idoodler/robo-garage/README.md

# Robo-Garage

Kitchen cabinet garage for a **Dreame L10s Pro Ultra Heat** robot vacuum.
ESP32 + ESPHome + Home Assistant: motorised door, light barrier, reed contacts, fan, LED ring, temperature/humidity, water leak probe + valve, buzzer.

**Live simulator:** https://claude.ai/artifact/KapGY8dMDmhuJijCuEXQXC

## Versions

| Part | Version | Status |
|---|---|---|
| Controller PCB | v1.3.1 | DRC 0 errors / 0 warnings (KiCad 7). JLCPCB assembles all parts (SMD + clamps), only the DevKitC is plugged in (USB-C reachable from outside). Power headroom: 12 V in 6 A, actuator 4.9 A limit, valve 3 A, every power path checked against IPC-2221. v1.3.1: clamp pins in 2 rows like the real part, pick & place rotations computed from JLC's own footprints |
| Case | v1.3.1 | fits PCB v1.3.1 (0 mm³ overlap with the part stand-in), DevKit USB-C through the left wall |
| ESPHome config | – | checked with ESPHome 2026.10.2. Set in HA without reflashing: beam type, actuator type (with / without built-in limit switches), open / close time, motor current threshold, stall current; "Door motor fault" when a move draws no current. Light barrier: retroreflective NPN sensor (E3Z-R61 type, Light-ON) + reflector on the BEAM clamp, blue wire on TX− so the self-test can switch it off (no PCB change). Line LED: SK6812 RGBW 144/m, 72 LEDs, capped at 25 % per channel (≤ 1.44 A of the 1.5 A LED output) |
| Simulator | v5.6 | door open slider for all 4 door types, printed door parts (doors v2.2) in 3D + side view, door downloads, retroreflective light barrier with its reflector, Line LED with 72 SK6812 RGBW LEDs |
| Doors | v2.2 | Printed parts for all 4 door types (lift door, flap out, up & over, parallel lift), no supports. Up & over + parallel lift: print-in-place modules with hourglass joints and hollow pins, skeleton plates and arms checked by 3D FE as printed (`check_strength.py`): 12 % less filament than v2.1 (both module pairs together), the most loaded spot down from 1.35 to 0.87 of its allowable at a 100 N stall (calculated), checked over the whole travel (joint gap 0.45 mm, up & over peg in its track 0.4 mm, other gaps ≥ 1 mm). Parallel lift parks 23 mm out (40 mm max) |

## Folders

| Folder | What is inside |
|---|---|
| `esphome/` | ESPHome config for the board (needs `secrets.yaml` with `wifi_ssid`, `wifi_password`) |
| `homeassistant/` | Home Assistant blueprint `robo-garage.yaml`: door follows the robot vacuum, clean button, button ring + status LED, rear fan drying, iOS Live Activities, messages (see below) |
| `pcb/gen/` | PCB generator (Python + KiCad `pcbnew`). `parts.py` = single source of truth, `fplib.py` makes the own footprints (`pcb/lib/robo.pretty`) |
| `pcb/robo-garage/` | Work folder. Only `robo-garage.ses` (Freerouting result) is in git |
| `pcb/out/` | Order files: gerbers zip, BOM + CPL for JLCPCB, KiCad project, renders, `pin1-check.png`. **Order guide: `pcb/out/README.md`** |
| `case/` | 3D-printed case: OpenSCAD source, STL files, pictures, print guide |
| `doors/` | Printed door parts for all 4 door types: OpenSCAD source, STL files, check scripts, print + assembly guide (`doors/README.md`) |
| `simulator/` | Simulator web page: `robo-garage.html` (source) → `build_page.py` → `index.html` |

## Build

GitHub Actions runs all of this on every push (`.github/workflows/build.yml`).
Locally: run from the repo root. Tested with KiCad 7.0.11 (Python `pcbnew`), Python 3 + shapely 2.2, OpenSCAD 2021.01.

| Step | Command |
|---|---|
| PCB: bare board | `python3 pcb/gen/build.py` |
| PCB: tracks + GND pour + DRC | `python3 pcb/gen/finish.py` (stops with an error on any DRC issue) |
| PCB: gerbers, BOM, CPL, renders | `python3 pcb/gen/fab.py pcb/robo-garage/robo-garage_routed.kicad_pcb pcb/out` |
| PCB: copy to `pcb/out` + zip | `pcb/gen/package.sh` |
| PCB: re-route (optional) | `pcb/gen/pipeline.sh` (Freerouting is not deterministic: run it again if `finish.py` reports unconnected items) |
| Case: PCB data, STL, zip | `case/build.sh` |
| Doors: STL, zip | `doors/build.sh` (other joint gap: `doors/build.sh -D cj=0.35`) |
| Doors: motion, gap and overhang checks | `python3 doors/check_parallel.py`, `python3 doors/check_upover.py`, `python3 doors/check_simple.py` |
| Doors: strength (joint loads + 3D FE as printed, about 6 min on 32 cores, up to 48 GB; `--jobs=1` for less) | `python3 doors/check_strength.py` (misuse case: `--yank`) |
| Simulator page | `python3 simulator/build_files.py` (downloads, pictures, case + door GLB) then `python3 simulator/build_page.py` |
| Flash ESP32 | `esphome run esphome/robo-garage-pcb.yaml` |

| Tool | Needed for |
|---|---|
| Python packages `shapely` 2.2, `segno` 1.6 (QR code on the silkscreen) | `build.py`, `finish.py` |
| `kicad-cli`, `rsvg-convert`, Python package `Pillow` | `fab.py` |
| `zip` | `package.sh`, `case/build.sh`, `doors/build.sh` |
| `openscad`, font DejaVu Sans | `case/build.sh`, `doors/build.sh`, `simulator/build_files.py` |
| Python packages `trimesh`, `rtree`, `shapely`, `numpy`; `xvfb-run` for `render.py`; `scipy`, `pyamg` for `check_strength.py`; `matplotlib` for `paper_template.py` (run by `doors/build.sh`) | `doors/check_*.py`, `doors/render.py`, `doors/paper_template.py` |
| Python packages `Pillow`, `trimesh`, `numpy`, `shapely`, `fast-simplification` | `simulator/build_files.py` |
| Java, `xvfb-run`, `pcb/tools/freerouting-1.9.0.jar` ([Freerouting releases](https://github.com/freerouting/freerouting/releases)) | `pipeline.sh` only |

Moved a part in `parts.py`? Then the old tracks no longer fit: run `pcb/gen/pipeline.sh` and commit the new `pcb/robo-garage/robo-garage.ses`.

## Home Assistant

Blueprint `homeassistant/robo-garage.yaml` (HA 2026.7 or newer). Import it: *Settings → Automations & scenes → Blueprints → Import blueprint*, URL
`https://github.com/idoodler/robo-garage/blob/main/homeassistant/robo-garage.yaml`, then *Create automation* and pick the robot vacuum and the Robo-Garage entities.

| What happens | How |
|---|---|
| Robot leaves the dock or starts returning | door opens; not open within the time limit or a door motor fault → robot paused + message. Dreame mop wash / drying after the job (reports "cleaning" while docked) keeps the door shut |
| Robot back in the dock, job over, for 1 min (set it) | door closes; beam blocked → the controller reopens, the blueprint waits for a clear beam and tries again (3×), then a message. Dreame: waits while the job still runs in the dock (mop washing, recharge) |
| Clean button | robot docked → door opens, then the robot starts (not on a door motor fault). Robot out → sent home (or paused / nothing) |
| Button ring | on while the robot is parked (brightness set it, 0 = off), pulses during a job in the dock, blinks on a problem |
| Status LED (optional) | red strobe = problem, orange chase = door moving, blue bar = job progress ("Progress" effect + "Status LED progress" number), spinner = returning, pulse = washing / charging in the dock, green = done (2 min), dim pulse = mop wash after the job |
| Water leak, beam fault, motor fault, stall, supply low, robot error | message to the notify entities you pick, else a notification in HA |
| Rear fan | after parking (door closed): fan at 60 % for 60 min (set both, 0 % = off), then back to "Vent auto". Stops early when the robot leaves |
| iOS Live Activities (optional, pick the phones; English or German) | cleaning job: a bar per room, current room + %, phase (mop wash, to the station, ...), door opening / closing, then done / stopped / error; outside a job the door status. Problems: one red list of every robot, station and garage problem, "✅ Problem solved" when all are clear. Made for the Dreame integration (task status, state, current room, progress, error, station sensors + a text and a toggle helper) |
| HA or controller restart | door put back where it belongs |
| Optional | close the door while the robot is out (opens again on "returning"); keep the door open while the drawer is out |

The safety work stays in the firmware: beam stop, stall stop, leak valve.

## Release

| Step | What to do |
|---|---|
| 1 | Set the versions: `VERSION` in `pcb/gen/parts.py` (also printed on the board), `version` in `case/robo-garage-case.scad` |
| 2 | Push to `main` → GitHub Actions builds everything and checks the DRC |
| 3 | Push a tag: `git tag v1.3.1 && git push origin v1.3.1` → GitHub Actions publishes the release with both zips |
| or | On github.com: *Releases* → *Draft a new release* → new tag `v1.3.1` → *Publish*. The zips get attached about 2 min later |

Every build also keeps both zips for 30 days: *Actions* → run → *Artifacts*.
