idoodler/robo-garage/doors/parallel_template.pdf

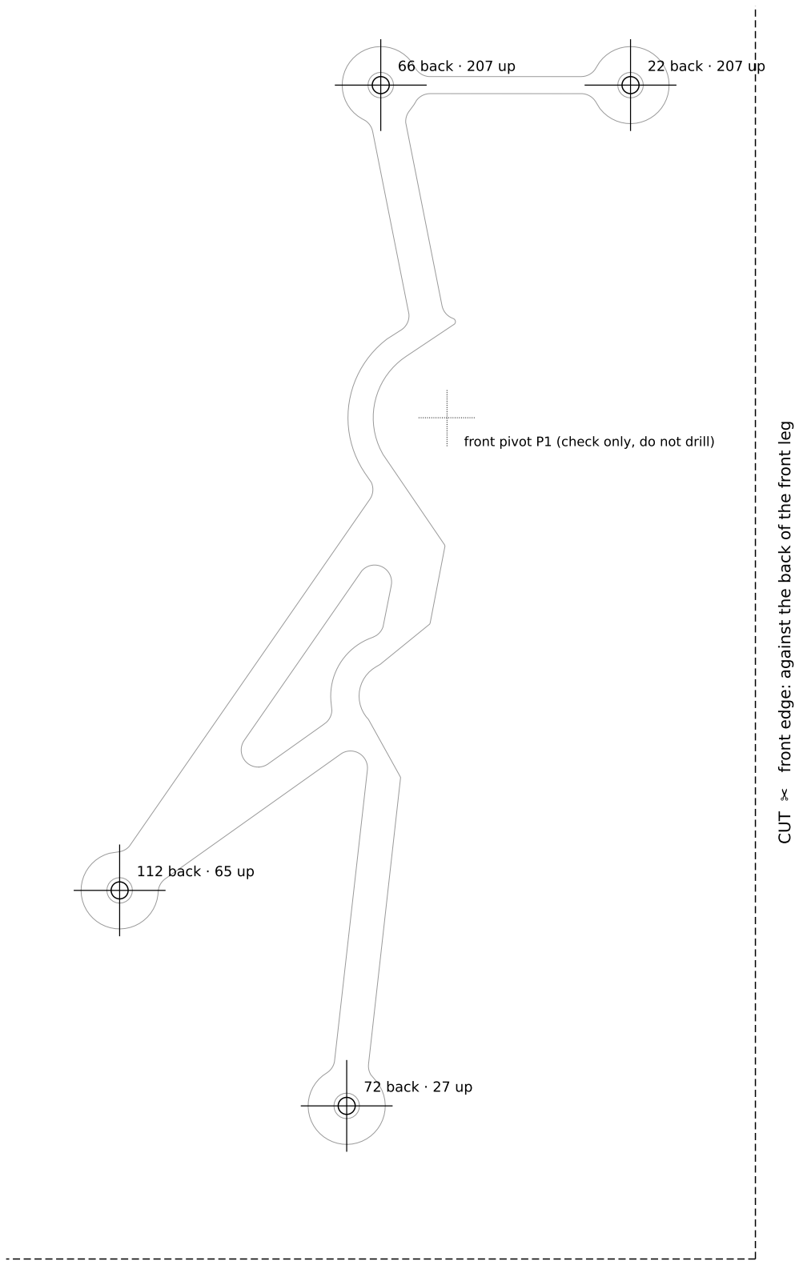
[picture p7: figure]
CUT; 66 back · 207 up; 22 back · 207 up; 72 back · 27 up; 112 back · 65 up

# ✂ front edge: against the back of the front leg

CUT ✂ bottom edge: on the tray front pivot P1 (check only, do not drill)

100 mm

100 mm

# Robo-Garage parallel lift v2.2: drill template, RIGHT cheek

Seen from the robot bay. Print on A4 at 100 % ("actual size", not "fit to page"): both bars must measure 100 mm.

Cut along both cut lines, tape it on, pre-drill the 4 crosses with 3 mm for 4 × 20 countersunk screws. Page 2 is the left cheek.

Hole positions from parallel-lift.scad (SCREWS); "back" = mm behind the front edge, "up" = mm above the tray.

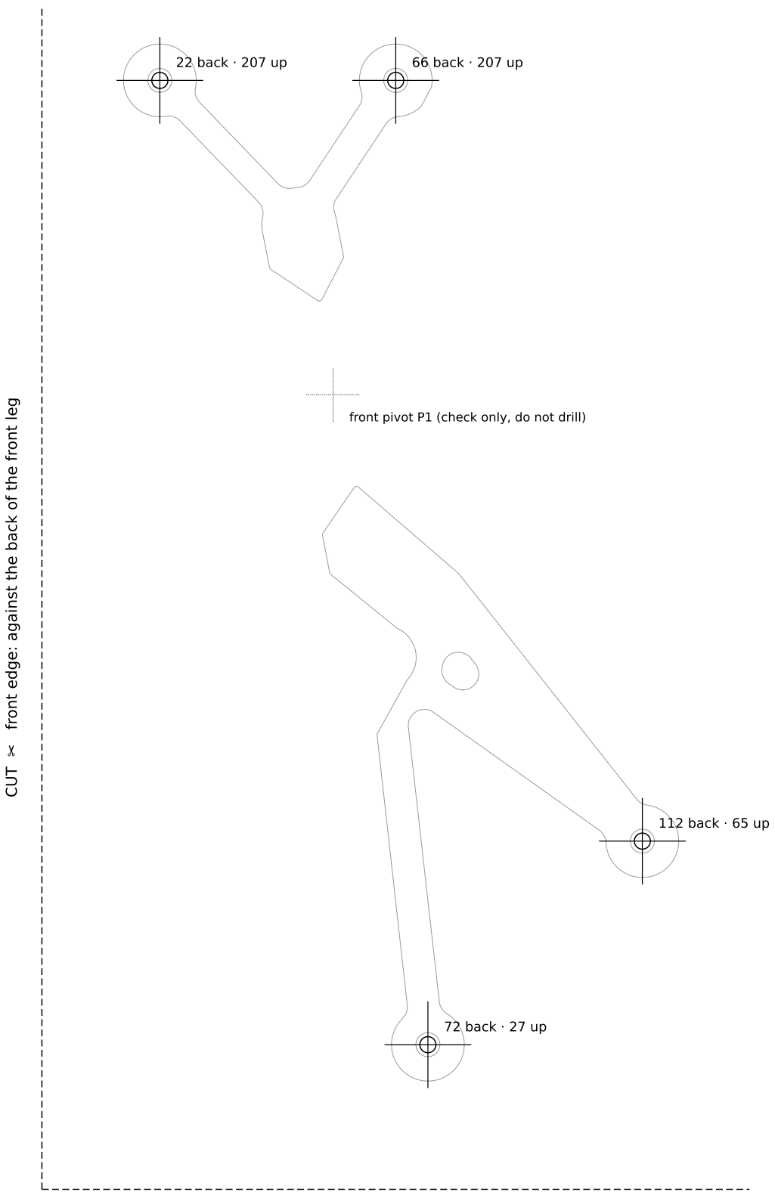
[picture p8: figure]
CUT; 22 back · 207 up; 66 back · 207 up; 72 back · 27 up; 112 back · 65 up

# ✂ front edge: against the back of the front leg

CUT ✂ bottom edge: on the tray front pivot P1 (check only, do not drill)

100 mm

100 mm

# Robo-Garage parallel lift v2.2: drill template, LEFT cheek

Seen from the robot bay. Print on A4 at 100 % ("actual size", not "fit to page"): both bars must measure 100 mm.

Cut along both cut lines, tape it on, pre-drill the 4 crosses with 3 mm for 4 × 20 countersunk screws. Page 1 is the right cheek.

Hole positions from parallel-lift.scad (SCREWS); "back" = mm behind the front edge, "up" = mm above the tray.
