idoodler/robo-garage/case/view_base.png

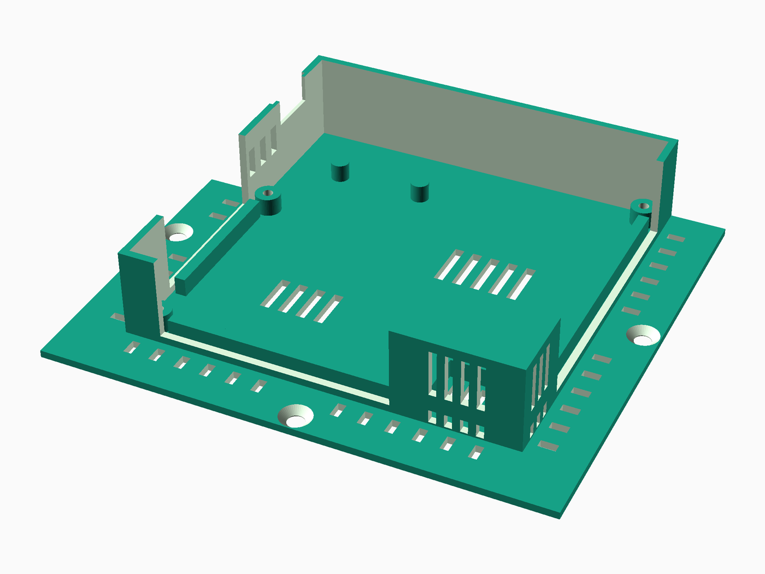
case/view_base.png
