idoodler/robo-garage/case/view_lid_top.png

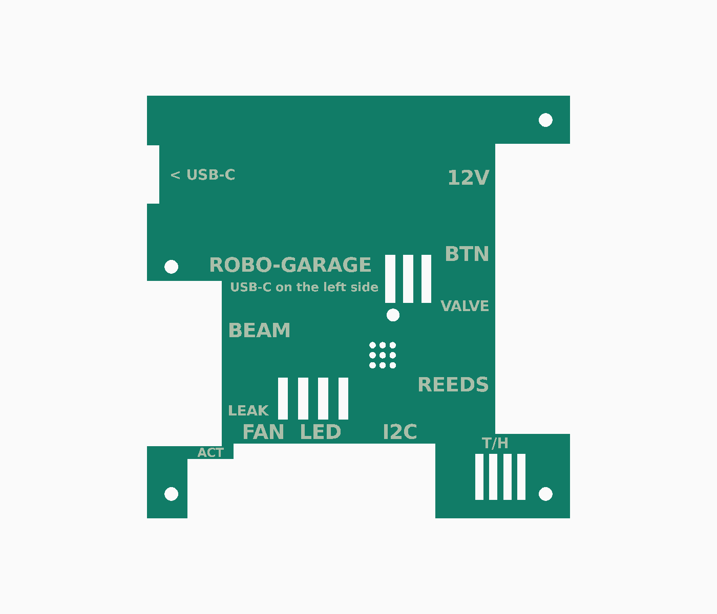
case/view_lid_top.png
