idoodler/robo-garage/pcb/out/pin1-check.png

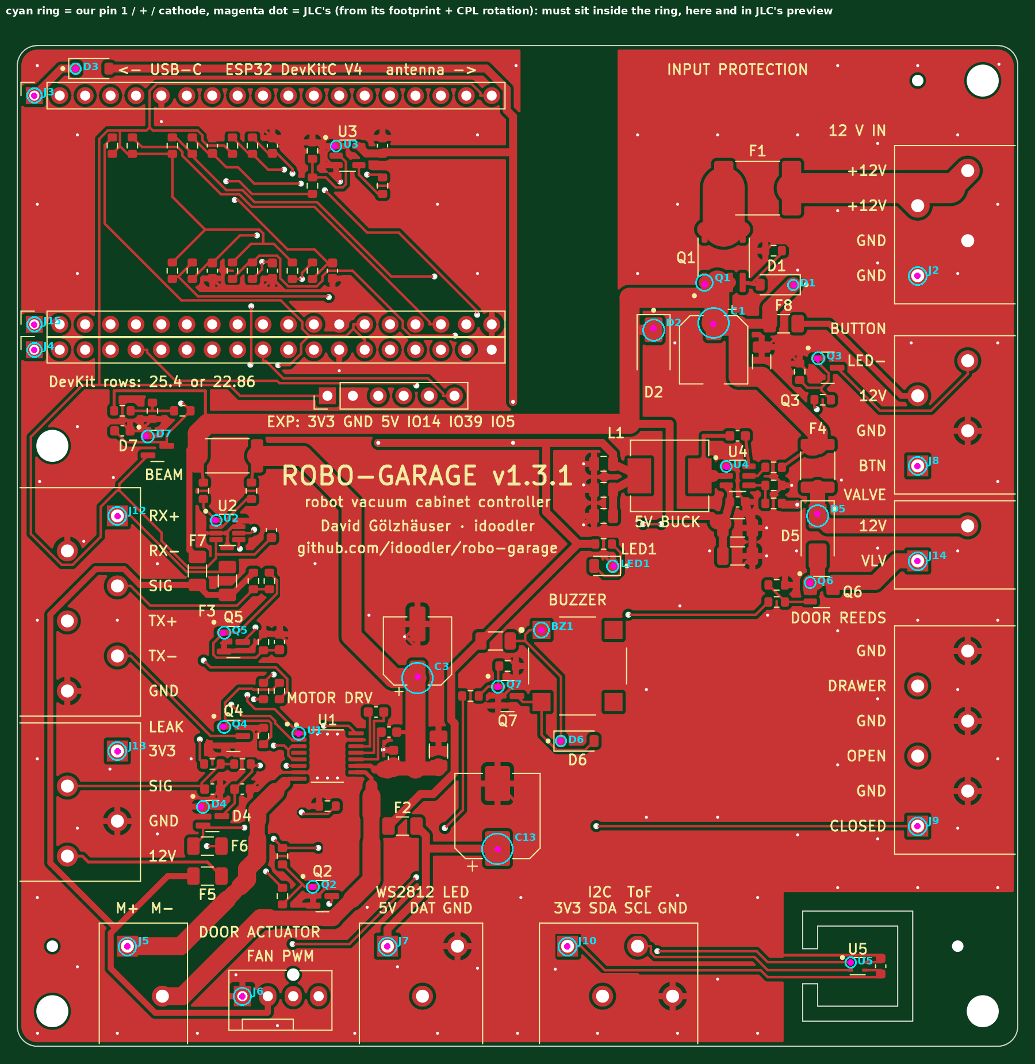
pcb/out/pin1-check.png
