idoodler/robo-garage/pcb/out/render_bottom.png

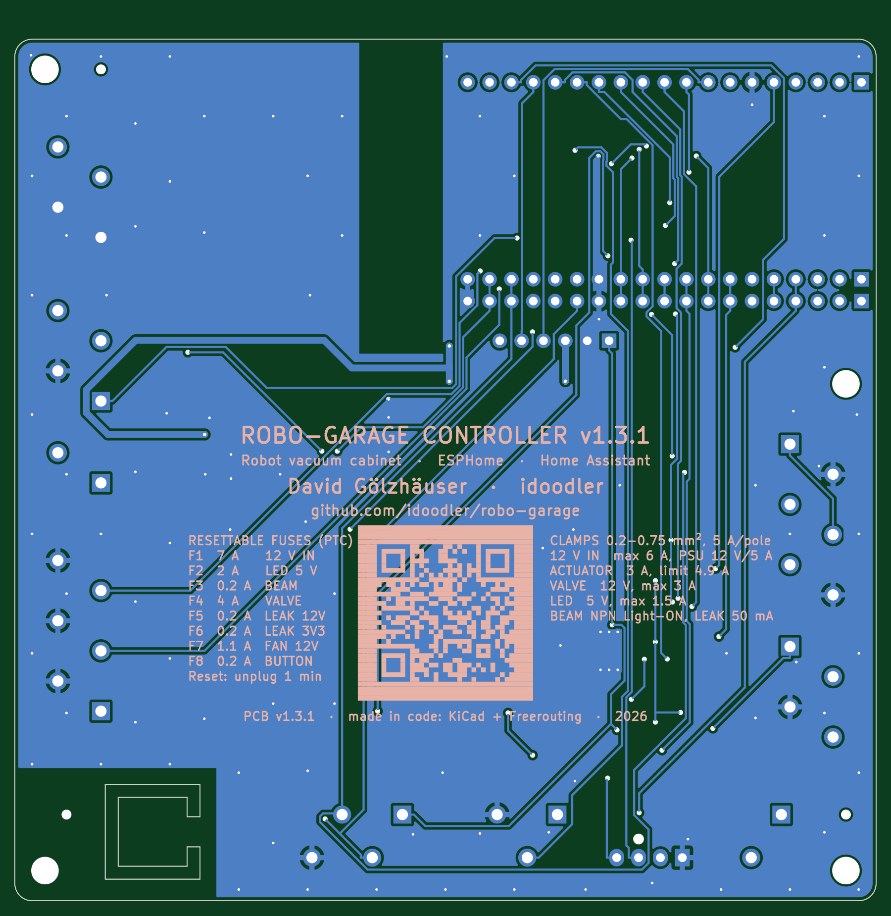
pcb/out/render_bottom.png
