idoodler/robo-garage/simulator/img/case-v1.3.1.webp

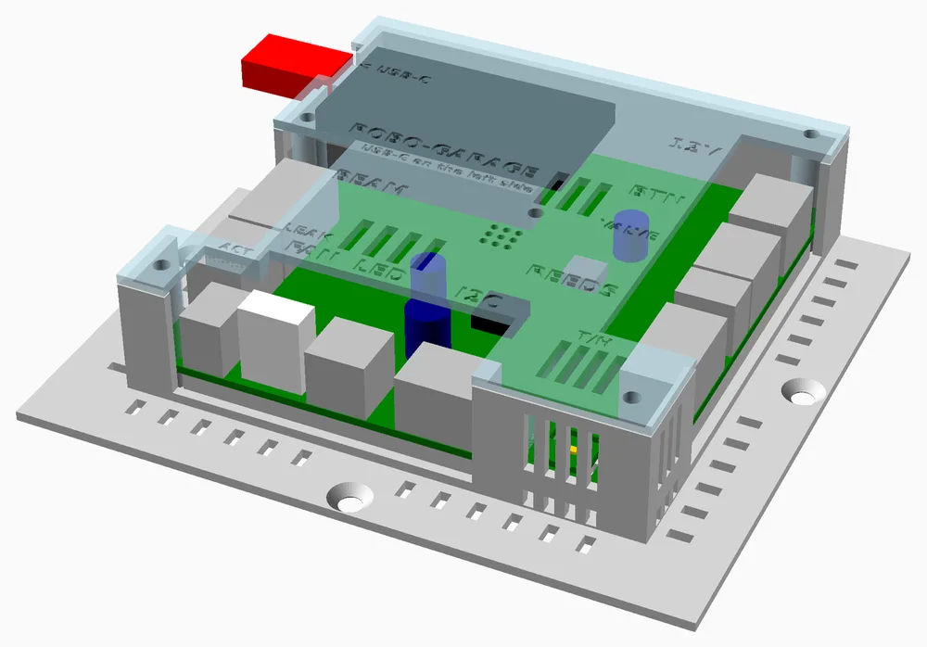
simulator/img/case-v1.3.1.webp
