idoodler/robo-garage/pcb/out/robo-garage_BOM_JLCPCB.csv

Comment | Designator | Footprint | LCSC Part # | MPN | Mount
MLT-8530 | BZ1 | Buzzer_SMD_MLT-8530_8.5x8.5mm | C94599 | MLT-8530 | SMD
100uF 25V | C1,C3 | CP_Elec_6.3x7.7 | C3338 | RVT1E101M0607 | SMD
10uF 50V | C2,C10,C22,C23 | C_1206_3216Metric | C13585 |  | SMD
100nF | C9,C11,C12,C16,C17,C18,C19,C20,C21,C28,C31,C32,C33 | C_0603_1608Metric | C14663 |  | SMD
470uF 16V | C13 | CP_Elec_8x10 | C970706 | RVT1C471M0810 | SMD
1nF | C15,C27,C30 | C_0603_1608Metric | C1588 |  | SMD
22uF 25V | C24,C25,C26 | C_0805_2012Metric | C45783 |  | SMD
22nF | C34 | C_0603_1608Metric | C21122 |  | SMD
BZT52C12 | D1 | D_SOD-123 | C43491 | BZT52C12 | SMD
SMAJ15A | D2 | D_SMA | C148216 | SMAJ15A | SMD
B5819W | D3,D6 | D_SOD-123 | C8598 | B5819W | SMD
BAT54S | D4,D7 | SOT-23 | C408389 | BAT54S | SMD
SS34 | D5 | D_SMA | C8678 | SS34 | SMD
PTC 7A 24V | F1 | Fuse_2920_7451Metric | C495361 | SMD2920P700SLR/24 | SMD
PTC 2A 12V | F2 | Fuse_1206_3216Metric | C883135 | BSMD1206-200-12V | SMD
PTC 200mA 30V | F3,F5,F6,F8 | Fuse_1206_3216Metric | C883118 | BSMD1206-020-30V | SMD
PTC 4A 16V | F4 | Fuse_1812_4532Metric | C47263807 | BSMD1812-400-16V | SMD
PTC 1.1A 30V | F7 | Fuse_1206_3216Metric | C21714343 | BSMD1206-110-30V | SMD
KF250-3.5-4P-1 | J2,J8,J10,J13 | KF250-3.5-4P_1x04_P3.50mm_45Degree | C475156 | KF250-3.5-4P-1 | THT
KH-2.54FH-1X19P-H8.5 | J3,J4,J15 | PinSocket_1x19_P2.54mm_Vertical_Tight | C2932678 | KH-2.54FH-1X19P-H8.5 | THT
KF250-3.5-2P-1 | J5,J14 | KF250-3.5-2P_1x02_P3.50mm_45Degree | C475154 | KF250-3.5-2P-1 | THT
Molex 47053-1000 | J6 | FanPinHeader_1x04_P2.54mm_Vertical | C240840 | Molex 47053-1000 | THT
KF250-3.5-3P-1 | J7 | KF250-3.5-3P_1x03_P3.50mm_45Degree | C475155 | KF250-3.5-3P-1 | THT
KF250-3.5-6P-1 | J9,J12 | KF250-3.5-6P_1x06_P3.50mm_45Degree | C475158 | KF250-3.5-6P-1 | THT
6.8uH 6A | L1 | L_Chilisin_BMRx00060630 | C167221 | FXL0630-6R8-M | SMD
green | LED1 | LED_0805_2012Metric | C2297 | KT-0805G | SMD
AO4407C | Q1 | SOIC-8_3.9x4.9mm_P1.27mm | C469397 | AO4407C | SMD
2N7002 | Q2,Q5 | SOT-23 | C8545 | 2N7002 | SMD
AO3400A | Q3,Q4,Q7 | SOT-23 | C20917 | AO3400A | SMD
IRLTS6342 | Q6 | SOT-23-6 | C152628 | IRLTS6342TRPBF | SMD
100k | R1,R16,R27,R34,R40,R47 | R_0603_1608Metric | C25803 |  | SMD
2.2k | R4 | R_0603_1608Metric | C4190 |  | SMD
1.5k | R5 | R_0603_1608Metric | C22843 |  | SMD
20m 2W | R6 | R_2512_6332Metric | C160589 | RLP25FEER020 | SMD
4.7k | R7,R8,R31 | R_0603_1608Metric | C23162 |  | SMD
330 | R9 | R_0603_1608Metric | C23138 |  | SMD
10k | R10,R12,R13,R17,R19,R20,R21,R26,R32,R35,R36,R41,R43,R46,R49 | R_0603_1608Metric | C25804 |  | SMD
100 | R11,R15,R33,R42,R45 | R_0603_1608Metric | C22775 |  | SMD
1k | R14,R18,R22,R23,R24,R30 | R_0603_1608Metric | C21190 |  | SMD
75k | R25 | R_0603_1608Metric | C23242 |  | SMD
0R | R28,R29 | R_0603_1608Metric | C21189 |  | SMD
10 1206 | R44 | R_1206_3216Metric | C17903 |  | SMD
22k | R48 | R_0603_1608Metric | C31850 |  | SMD
DRV8874PWPR | U1 | TI_PWP0016J_HTSSOP-16_ThermalVias | C1855818 | DRV8874PWPR | SMD
INA219AIDCNR | U2 | SOT-23-8 | C87469 | INA219AIDCNR | SMD
SN74AHCT1G125DBVR | U3 | SOT-23-5 | C7484 | SN74AHCT1G125DBVR | SMD
LMR51430XFDDCR | U4 | TSOT-23-6 | C5219260 | LMR51430XFDDCR | SMD
SHT41-AD1B | U5 | Sensirion_DFN-4_1.5x1.5mm_P0.8mm_SHT4x_NoCentralPad | C7461861 | SHT41-AD1B-R2 | SMD
