idoodler/robo-garage/case/base.stl

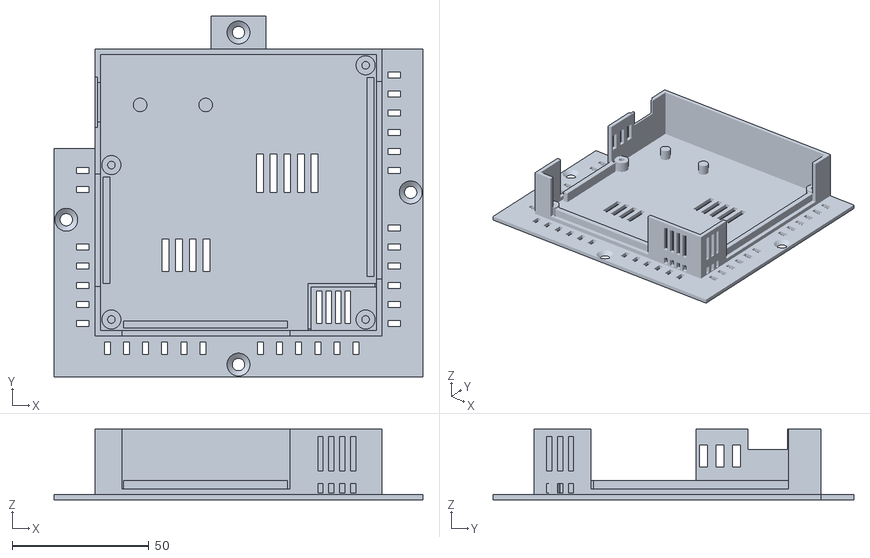
[picture p14: CAD file, 2026-11-03]
case/base.stl
135.0 x 132.0 x 25.8
