idoodler/robo-garage/doors/parallel_right.stl

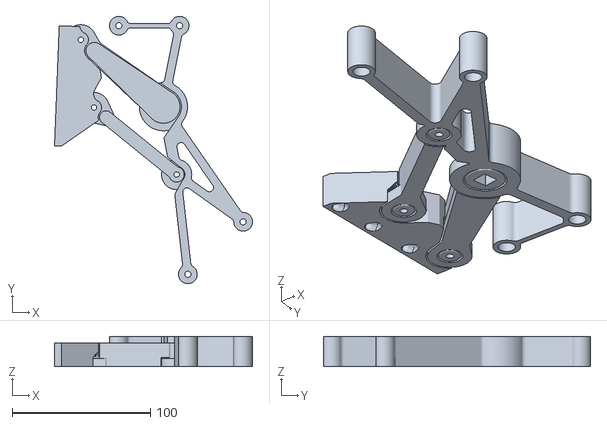
[picture p15: CAD file, 2026-11-08]
doors/parallel_right.stl
143.4 x 193.6 x 22.0
