idoodler/robo-garage/case/lid_print.stl

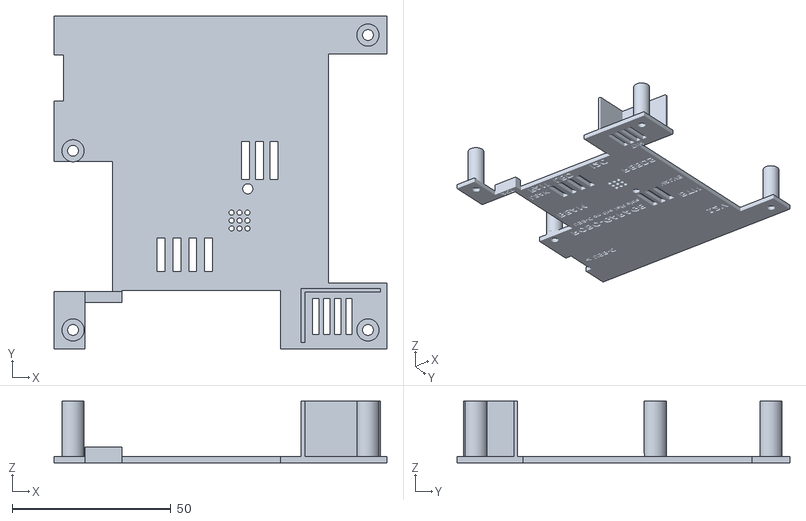
[picture p16: CAD file, 2026-11-03]
case/lid_print.stl
105.0 x 105.0 x 19.5
