idoodler/robo-garage/doors/coupon.stl

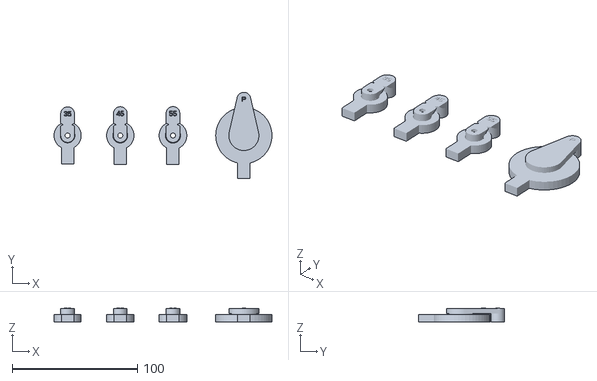
[picture p17: CAD file, 2026-11-08]
doors/coupon.stl
173.8 x 68.9 x 11.1
