idoodler/robo-garage/doors/upover_left.stl

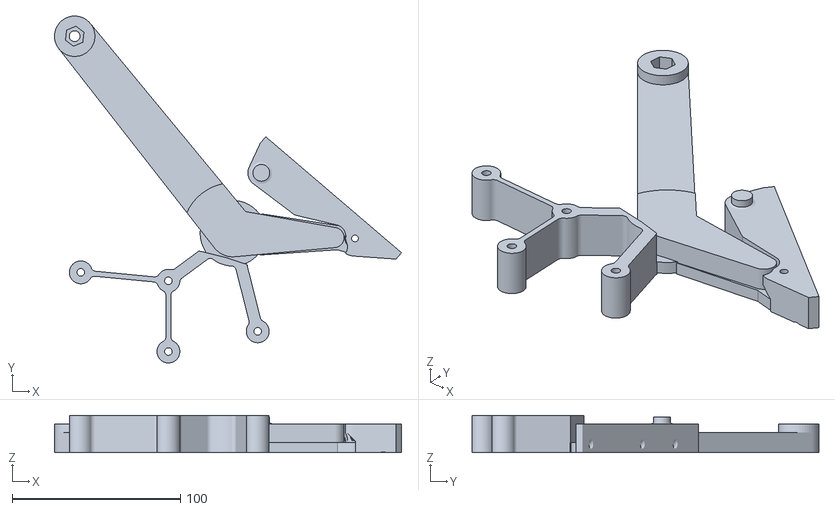
[picture p18: CAD file, 2026-11-08]
doors/upover_left.stl
206.0 x 205.9 x 22.0
