idoodler/robo-garage/doors/upover_template.stl

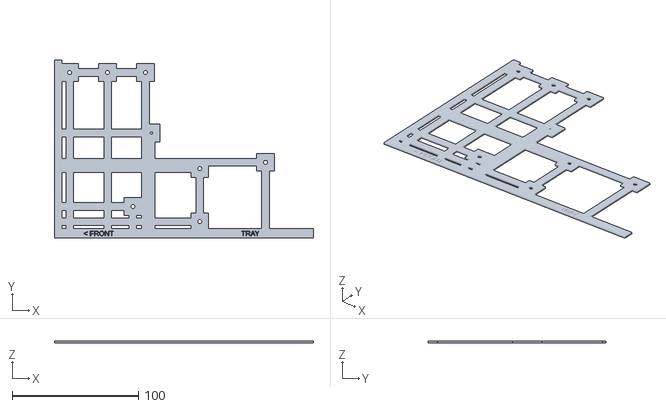
[picture p19: CAD file, 2026-11-08]
doors/upover_template.stl
205.0 x 141.1 x 1.20
