idoodler/robo-garage/doors/parallel_left.stl

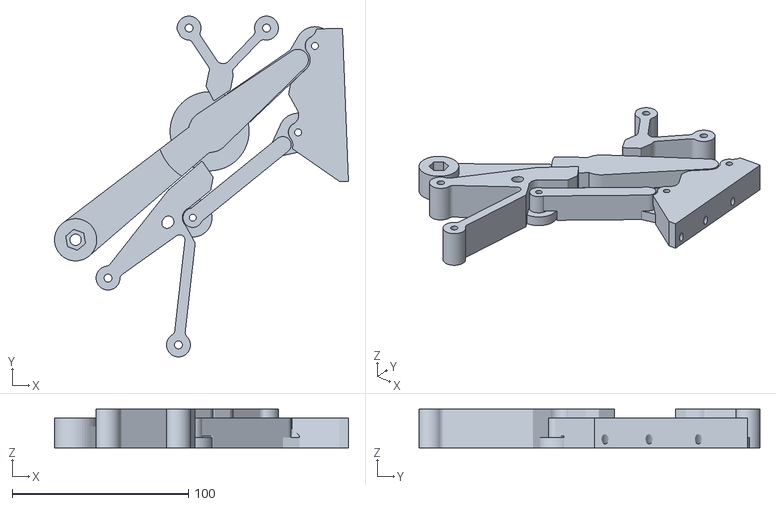
[picture p20: CAD file, 2026-11-08]
doors/parallel_left.stl
167.0 x 193.6 x 22.0
