idoodler/robo-garage/doors/upover_right.stl

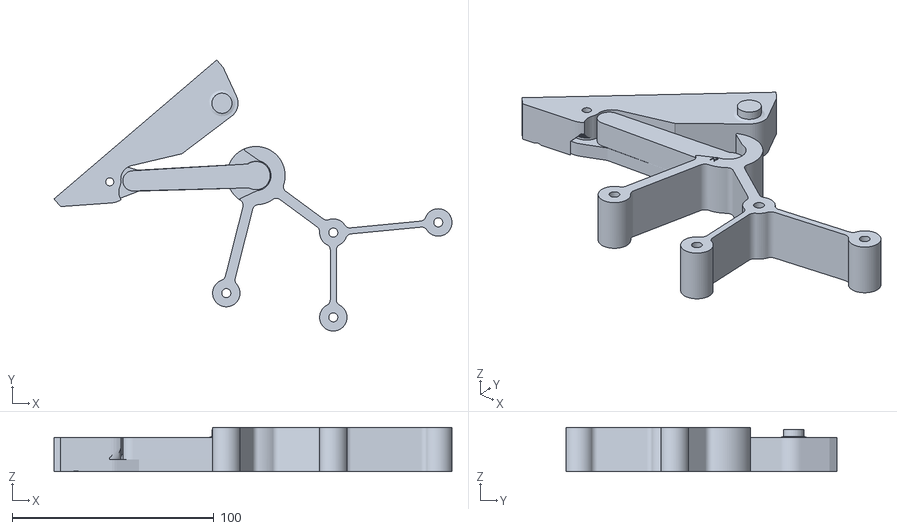
[picture p21: CAD file, 2026-11-08]
doors/upover_right.stl
197.1 x 134.3 x 22.0
