idoodler/robo-garage/doors/upover_track_right.stl

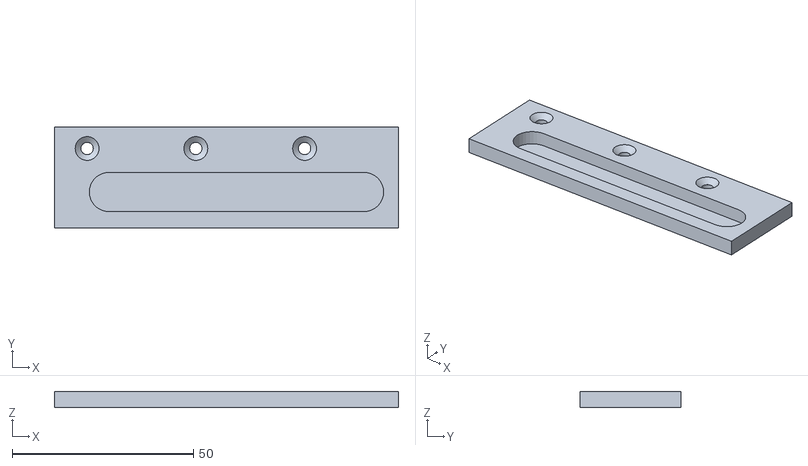
[picture p22: CAD file, 2026-11-07]
doors/upover_track_right.stl
94.9 x 28.0 x 4.50
