idoodler/robo-garage/doors/lift_channel.stl

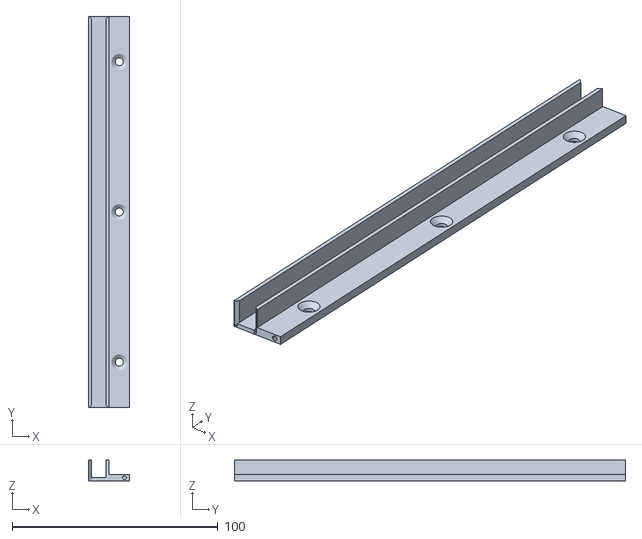
[picture p23: CAD file, 2026-11-07]
doors/lift_channel.stl
20.0 x 190.0 x 10.0
