idoodler/robo-garage/doors/flap_mount.stl

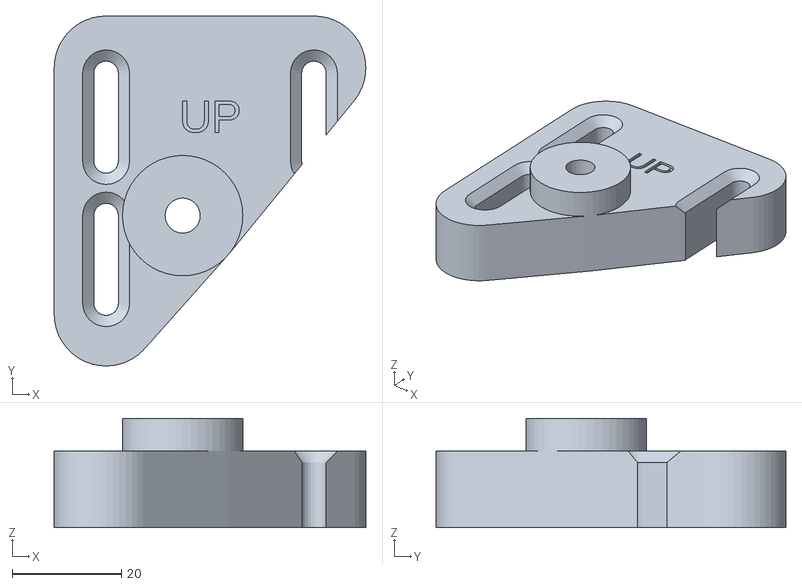
[picture p24: CAD file, 2026-11-07]
doors/flap_mount.stl
57.0 x 64.0 x 20.0
