idoodler/robo-garage/doors/flap_lever.stl

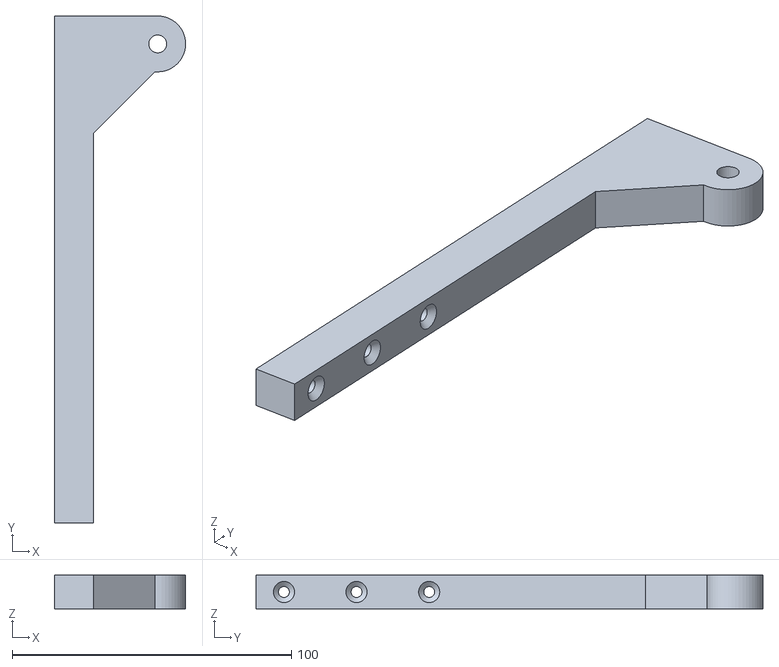
[picture p25: CAD file, 2026-11-07]
doors/flap_lever.stl
47.0 x 181.5 x 12.0
