idoodler/robo-garage/doors/lift_foot.stl

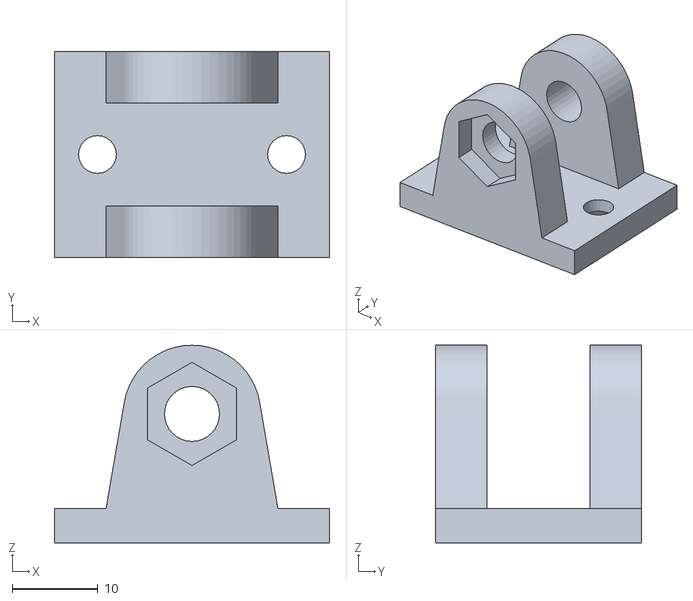
[picture p26: CAD file, 2026-11-07]
doors/lift_foot.stl
32.0 x 24.0 x 23.0
