idoodler/robo-garage/doors/upover_mount.stl

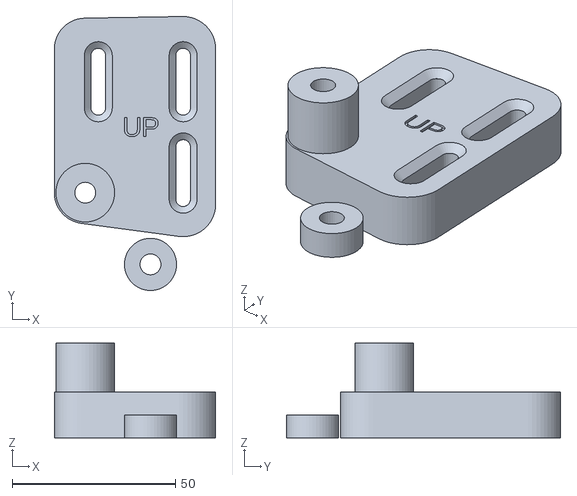
[picture p27: CAD file, 2026-11-07]
doors/upover_mount.stl
49.5 x 84.0 x 29.0
