idoodler/robo-garage/doors/parallel_mount.stl

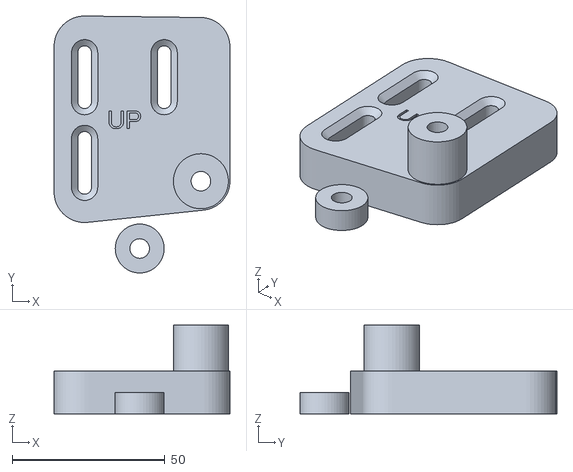
[picture p28: CAD file, 2026-11-07]
doors/parallel_mount.stl
57.5 x 84.0 x 29.0
