idoodler/robo-garage/doors/lift_clamp.stl

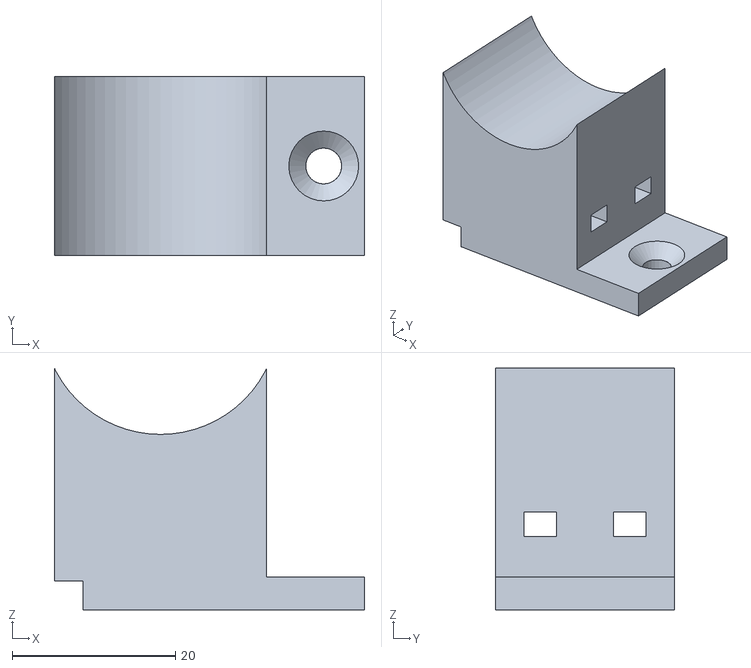
[picture p29: CAD file, 2026-11-07]
doors/lift_clamp.stl
38.0 x 22.0 x 29.6
