idoodler/robo-garage/doors/lift_saddle.stl

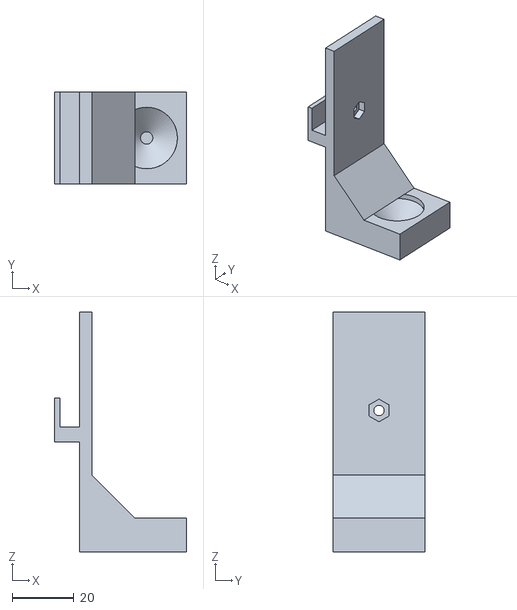
[picture p30: CAD file, 2026-11-07]
doors/lift_saddle.stl
43.0 x 30.0 x 78.0
