idoodler/robo-garage/case/pcb_data.scad

// generated by gen_pcb_data.py from parts.py (PCB v1.3.1) - SCAD coords, y up
holes = [[96.5, 3.5], [3.5, 3.5], [96.5, 96.5], [3.5, 60.0]];
wago = [[87.8, 74.3, 99.8, 89.9, 11.7], [8.3, 0.2, 16.9, 12.2, 11.7], [34.3, 0.2, 46.4, 12.2, 11.7], [52.3, 0.2, 67.9, 12.2, 11.7], [87.8, 55.3, 99.8, 70.9, 11.7], [87.8, 19.3, 99.8, 41.9, 11.7], [0.2, 33.1, 12.2, 55.7, 11.7], [0.2, 16.6, 12.2, 32.2, 11.7], [87.8, 45.8, 99.8, 54.4, 11.7]];  // J2,J5,J7,J10,J8,J9,J12,J13,J14
led1 = [58.6, 48.0];
c1_pos = [69.6, 69.6];
c3_pos = [40.0, 39.5];
c13_pos = [48.0, 23.0];
l1_pos = [65.2, 57.0];
u4_pos = [72.0, 57.0];
u1_pos = [31.0, 29.0];
j6_pos = [22.5, 5.0];
u5_pos = [84.0, 8.0];
c28_pos = [86.3, 8.0];
bz_pos = [56.0, 38.0];
devkit = [-0.98, 54.85, 82.3, 83.57];  // USB-C face x, antenna end x, USB-C centre y (25.4 mm board / 22.86 mm board)
slot_outer = [78.5, 2.5, 89.5, 13.5];  // C-slot around the SHT40 island [x0, y0, x1, y1]
chamber = [76.0, 0.0, 100.0, 16.0];  // sensor chamber: partitions at x0 and y1
