idoodler/robo-garage/(list of files, cad)

Other CAD files:
doors/upover_track_left.stl
