idoodler/robo-garage/case/view_assembly.png

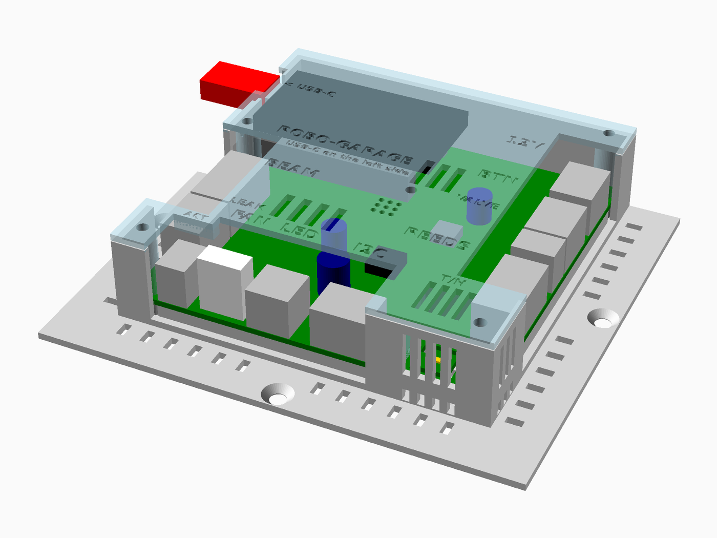
case/view_assembly.png
