idoodler/robo-garage/(list of files, drawings)

Other design files:
simulator/files/pcb-v1.3.1.json
