idoodler/robo-garage/pcb/out/kicad/robo-garage.kicad_pcb

## KiCad design pcb/out/kicad/robo-garage.kicad_pcb (2026-11-03)

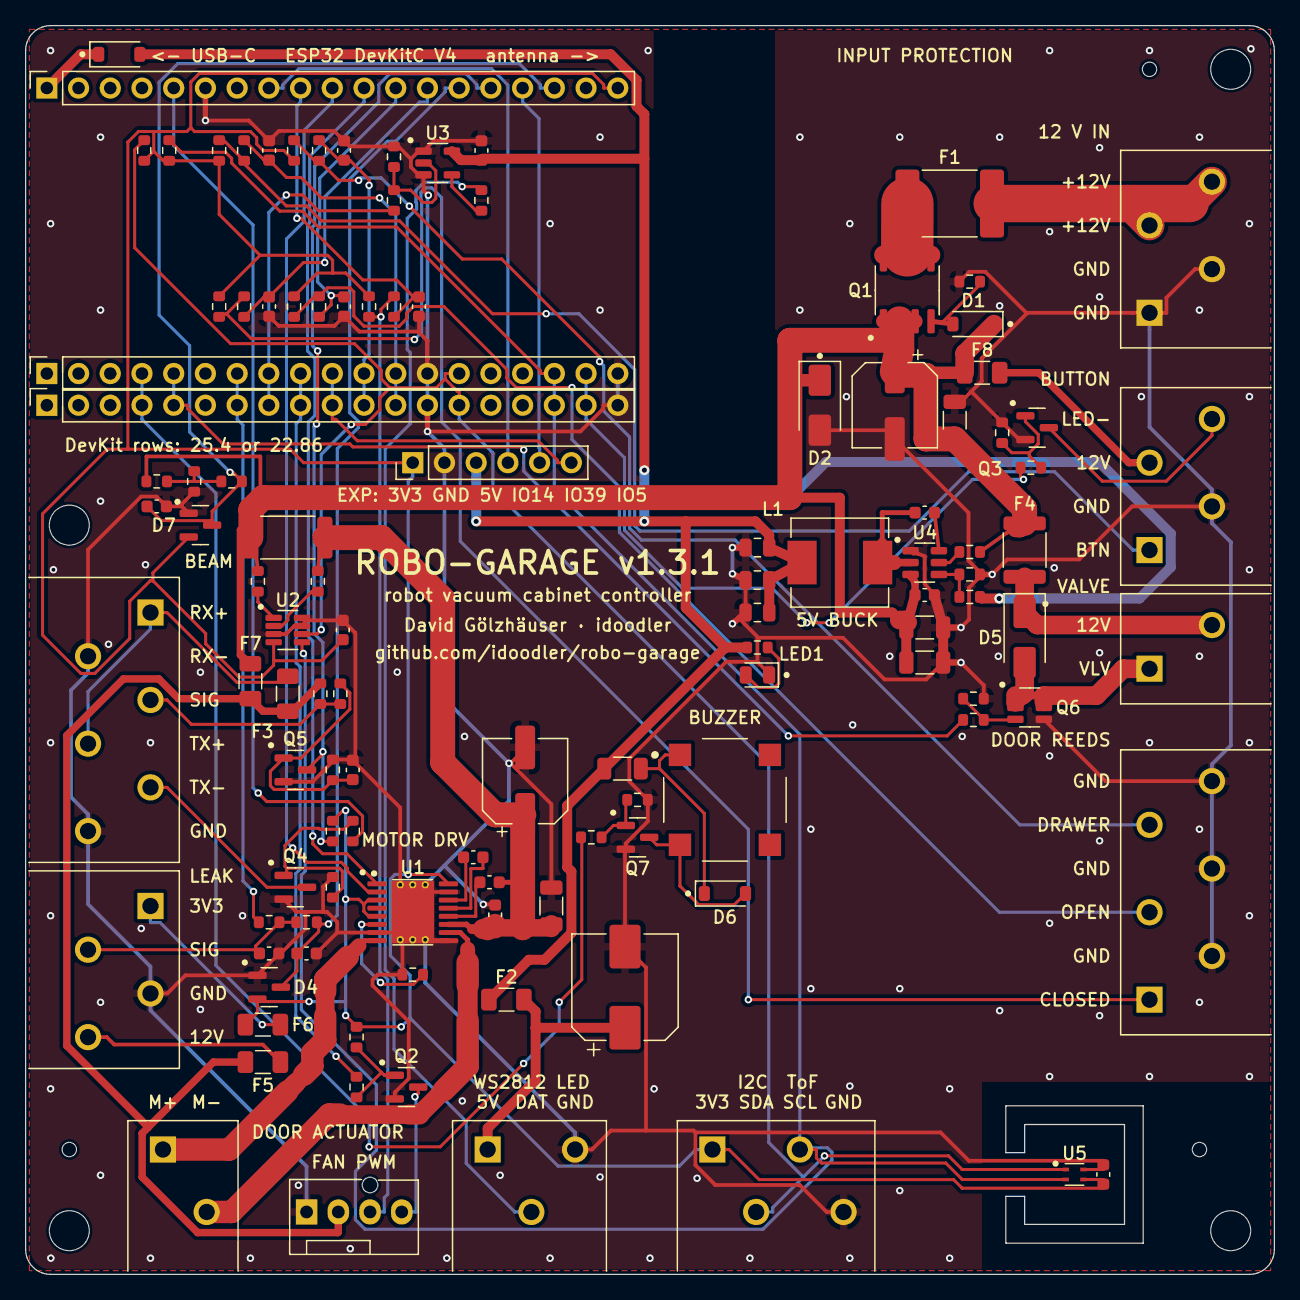
[picture p32: board robo-garage.kicad_pcb from above]

Board: 2 copper layers, 100.0 x 100.0 mm, 122 parts (0 on the bottom side), 74 nets.

Parts:
BZ1: MLT-8530; Buzzer_SMD_MLT-8530_8.5x8.5mm
C1, C3: 100uF 25V; CP_Elec_6.3x7.7
C2, C10, C22, C23: 10uF 50V; C_1206_3216Metric
C9, C11, C12, C16, C17, C18, C19, C20, C21, C28, C31, C32, C33: 100nF; C_0603_1608Metric
C13: 470uF 16V; CP_Elec_8x10
C15, C27, C30: 1nF; C_0603_1608Metric
C24, C25, C26: 22uF 25V; C_0805_2012Metric
C34: 22nF; C_0603_1608Metric
D1: BZT52C12; D_SOD-123
D2: SMAJ15A; D_SMA
D3, D6: B5819W; D_SOD-123
D4, D7: BAT54S; SOT-23
D5: SS34; D_SMA
F1: PTC 7A 24V; Fuse_2920_7451Metric
F2: PTC 2A 12V; Fuse_1206_3216Metric
F3, F5, F6, F8: PTC 200mA 30V; Fuse_1206_3216Metric
F4: PTC 4A 16V; Fuse_1812_4532Metric
F7: PTC 1.1A 30V; Fuse_1206_3216Metric
H1, H2, H3, H4: M3; MountingHole_3.2mm_M3
J2: 12V IN; KF250-3.5-4P_1x04_P3.50mm_45Degree
J3: DevKitC socket (5V..3V3); PinSocket_1x19_P2.54mm_Vertical_Tight
J4: DevKitC socket (CLK..GND) outer 25.4; PinSocket_1x19_P2.54mm_Vertical_Tight
J5: ACTUATOR; KF250-3.5-2P_1x02_P3.50mm_45Degree
J6: Fan 4-pin; FanPinHeader_1x04_P2.54mm_Vertical
J7: LED; KF250-3.5-3P_1x03_P3.50mm_45Degree
J8: BUTTON; KF250-3.5-4P_1x04_P3.50mm_45Degree
J9: REEDS; KF250-3.5-6P_1x06_P3.50mm_45Degree
J10: I2C; KF250-3.5-4P_1x04_P3.50mm_45Degree
J11: EXP (optional); PinHeader_1x06_P2.54mm_Vertical
J12: BEAM; KF250-3.5-6P_1x06_P3.50mm_45Degree
J13: LEAK; KF250-3.5-4P_1x04_P3.50mm_45Degree
J14: VALVE; KF250-3.5-2P_1x02_P3.50mm_45Degree
J15: DevKitC socket (CLK..GND) inner 22.86; PinSocket_1x19_P2.54mm_Vertical_Tight
L1: 6.8uH 6A; L_Chilisin_BMRx00060630
LED1: green; LED_0805_2012Metric
Q1: AO4407C; SOIC-8_3.9x4.9mm_P1.27mm
Q2, Q5: 2N7002; SOT-23
Q3, Q4, Q7: AO3400A; SOT-23
Q6: IRLTS6342; SOT-23-6
R1, R16, R27, R34, R40, R47: 100k; R_0603_1608Metric
R4: 2.2k; R_0603_1608Metric
R5: 1.5k; R_0603_1608Metric
R6: 20m 2W; R_2512_6332Metric
R7, R8, R31: 4.7k; R_0603_1608Metric
R9: 330; R_0603_1608Metric
R10, R12, R13, R17, R19, R20, R21, R26, R32, R35, R36, R41, R43, R46, R49: 10k; R_0603_1608Metric
R11, R15, R33, R42, R45: 100; R_0603_1608Metric
R14, R18, R22, R23, R24, R30: 1k; R_0603_1608Metric
R25: 75k; R_0603_1608Metric
R28, R29: 0R; R_0603_1608Metric
R44: 10 1206; R_1206_3216Metric
R48: 22k; R_0603_1608Metric
TH1, TH2, TH3: tooling; ToolingHole_JLCPCB_1.152mm
U1: DRV8874PWPR; TI_PWP0016J_HTSSOP-16_ThermalVias
U2: INA219AIDCNR; SOT-23-8
U3: SN74AHCT1G125DBVR; SOT-23-5
U4: LMR51430XFDDCR; TSOT-23-6
U5: SHT41-AD1B; Sensirion_DFN-4_1.5x1.5mm_P0.8mm_SHT4x_NoCentralPad

Connections:
+3V3: C11.1, C28.1, D4.2, D7.2, F6.1, J3.19, J10.1, J11.1, R7.1, R8.1, R12.2, R13.2, R17.1, R19.2, R20.2, R21.1, R36.2, U1.3, U1.5, U1.16, U2.4, U5.3
+3V3_LK: F6.2, J13.1
+5V: C12.1, C24.2, C25.2, C26.2, D3.2, F2.1, J11.3, L1.1, R4.1, R25.2, R44.1, U3.5
+5V_DEV: D3.1, J3.1
+5V_LED: C13.1, F2.2, J7.1
+12V: C1.1, C2.1, C21.1, C22.1, C23.1, D1.1, D2.1, F4.1, F7.1, F8.1, Q1.1, Q1.2, Q1.3, R6.1, R27.2, R28.1, R47.1, U4.3
+12V_A: F3.1, F5.1, F7.2, J6.2, R31.2
+12V_BTN: F8.2, J8.3
+12V_F: F1.2, Q1.5, Q1.6, Q1.7, Q1.8
+12V_IN: F1.1, J2.3, J2.4
+12V_LK: F5.2, J13.4
+12V_MOT: C3.1, C9.1, C10.1, C33.2, R6.2, R29.1, U1.11
+12V_VLV: D5.1, F4.2, J14.2
BEAM_12V: F3.2, J12.1, J12.4
BEAM_SIG: J12.3, R31.1, R32.1
BEAM_TX: J12.5, Q4.3
BTN: J8.1, R17.2, R18.1
BZ_K: BZ1.2, D6.2, Q7.3
BZ_P: BZ1.1, D6.1, R44.2
CB: C20.2, U4.6
CPH: C34.2, U1.13
CPL: C34.1, U1.14
EN: R27.1, U4.5
FAN_PWM: J6.4, Q2.3
FAN_TACH: J6.3, R13.1, R14.2
FB: R25.1, R26.1, U4.4
GND: C1.2, C2.2, C3.2, C9.2, C10.2, C11.2, C12.2, C13.2, C15.1, C16.2, C17.1, C18.1, C19.2, C21.2, C22.2, C23.2, C24.1, C25.1, C26.1, C27.2, C28.2, C30.2, C31.2, C32.2, D2.2, D4.1, D7.1, J2.1, J2.2, J3.6, J4.13, J4.19, J6.1, J7.3, J8.2, J9.2, J9.4, J9.6, J10.4, J11.2, J12.2, J12.6, J13.3, J15.13, J15.19, LED1.1, Q2.2, Q3.2, Q4.2, Q5.2, Q6.4, Q7.2, R1.1, R5.1, R10.2, R16.2, R26.2, R34.2, R35.2, R43.2, R46.2, R48.2, U1.7, U1.9, U1.15, U1.17, U2.3, U2.7, U2.8, U3.1, U3.3, U4.1, U5.4
IO2: J4.5, J15.5, R42.1
IO4: J4.7, J15.7, R40.1
IO5: J4.10, J11.6, J15.10
IO13: J3.5, R33.1
IO14: J3.8, J11.4
IO15: J4.4, J15.4, R45.1
IO16: J4.8, J15.8, R30.1
IO17: J4.9, J15.9, R11.2
IO18: C19.1, J4.11, J15.11, R24.2
IO19: C16.1, J4.12, J15.12, R18.2
IO21: J4.14, J10.2, J15.14, R7.2, U2.6, U5.1
IO22: J4.17, J10.3, J15.17, R8.2, U2.5, U5.2
IO23: J4.18, J15.18, R15.1
IO25: J3.11, U1.1
IO26: J3.10, U1.2
IO27: C15.2, J3.9, R14.1
IO32: C17.2, J3.13, R22.1
IO33: C18.2, J3.12, R23.1
IO34: J3.15, Q5.3, R36.1
IO35: C31.1, D4.3, J3.14, R41.2
IPROPI: R5.2, U1.6
ISNS_N: R29.2, U2.2
ISNS_P: R28.2, U2.1
LEAK_S: C30.1, J13.2, R40.2, R41.1
LED_BUF: R9.1, U3.4
LED_DATA: J7.2, R9.2
LED_IN: R10.1, R30.2, U3.2
LED_PWR: LED1.2, R4.2
MOT_A: J5.1, U1.8
MOT_B: J5.2, U1.10
Q1_G: D1.2, Q1.4, R1.2
Q2_G: Q2.1, R11.1, R12.1
Q3_G: Q3.1, R15.2, R16.1
Q4_G: Q4.1, R33.2, R34.1
Q5_G: C27.1, Q5.1, R32.2, R35.1
Q6_G: Q6.3, R42.2, R43.1
Q7_G: Q7.1, R45.2, R46.1
REED_CL: J9.1, R19.1, R22.2
REED_DR: J9.5, R21.2, R24.1
REED_OP: J9.3, R20.1, R23.2
RING_K: J8.4, Q3.3
SW: C20.1, L1.2, U4.2
VALVE_K: D5.2, J14.1, Q6.1, Q6.2, Q6.5, Q6.6
VCP: C33.1, U1.12
VMON: R47.2, R48.1, R49.1
VN: J3.16, J11.5
VP: C32.1, D7.3, J3.17, R49.2
