idoodler/robo-garage/pcb/gen/parts.py

# Robo-Garage controller PCB - parts, footprints, nets, placement, LCSC numbers (single source of truth)
# Coordinates in mm, KiCad board coords (x right, y down); board 100 x 100 mm, top-left at (0, 0).
# rot = KiCad footprint rotation in degrees (CCW).

VERSION = '1.3.1'   # PCB version: silkscreen title + release zip name (pcb/gen/package.sh)

W, H = 100.0, 100.0

# ---- ESP32 DevKitC V4, v1.2: USB-C at the LEFT board edge (plug in through the case wall), antenna end inboard
# over a copper keep-out. Rotated 180 deg vs. v1.1: top row = DevKit J2 side (5V .. 3V3), bottom rows = J3 side
# (CLK .. GND), pin 19 of the DevKit (USB end) sits in socket pin 1 at x = 1.7, dual column 22.86 / 25.4 mm.
J3_PINS = ['GND', 'IO23', 'IO22', 'TXD', 'RXD', 'IO21', 'GND', 'IO19', 'IO18', 'IO5', 'IO17', 'IO16', 'IO4',
           'IO0', 'IO2', 'IO15', 'SD1', 'SD0', 'CLK']
J2_PINS = ['+3V3', 'EN', 'VP', 'VN', 'IO34', 'IO35', 'IO32', 'IO33', 'IO25', 'IO26', 'IO27', 'IO14', 'IO12',
           'GND', 'IO13', 'SD2', 'SD3', 'CMD', '+5V_DEV']
# VP = GPIO36, VN = GPIO39 (input only, ADC1). v1.2 adds IO2 (valve), IO15 (buzzer), VP (12 V monitor),
# IO35 (leak probe, ADC1), VN + IO5 (EXP header spares).
USED = {'GND', 'IO23', 'IO22', 'IO21', 'IO19', 'IO18', 'IO17', 'IO16', 'IO4', '+3V3', 'IO32', 'IO33', 'IO25',
        'IO26', 'IO27', 'IO14', 'IO13', '+5V_DEV', 'IO34', 'IO35', 'IO2', 'IO15', 'VP', 'VN', 'IO5'}
DK_X0, DK_Y0 = 1.7, 5.0         # socket pin 1 (DevKit USB end); the USB-C face ends up 1.0 mm outside the board edge
ANT_KEEPOUT = [(50.3, 0.5, 60.0, 36.5)]   # no copper / tracks under the module antenna (x 49..55); a 2 mm corridor
                                           # stays open between the socket ends (48.7) and the zone for the power tracks
ROW_NARROW, ROW_WIDE = 22.86, 25.4


def j_top_nets():      # DevKit J2 side, reversed: socket pin 1 = 5V (USB end) ... pin 19 = 3V3 (antenna end)
    return {str(k + 1): (n if n in USED else None) for k, n in enumerate(reversed(J2_PINS))}


def j_bot_nets():      # DevKit J3 side, reversed: socket pin 1 = CLK (USB end) ... pin 19 = GND (antenna end)
    return {str(k + 1): (n if n in USED else None) for k, n in enumerate(reversed(J3_PINS))}


R0603 = ('Resistor_SMD', 'R_0603_1608Metric')
C0603 = ('Capacitor_SMD', 'C_0603_1608Metric')
C0805 = ('Capacitor_SMD', 'C_0805_2012Metric')
C1206 = ('Capacitor_SMD', 'C_1206_3216Metric')
SOT23 = ('Package_TO_SOT_SMD', 'SOT-23')
SOT23_6 = ('Package_TO_SOT_SMD', 'SOT-23-6')
SOIC8 = ('Package_SO', 'SOIC-8_3.9x4.9mm_P1.27mm')
R1206 = ('Resistor_SMD', 'R_1206_3216Metric')
F1206, F1812, F2920 = ('Fuse', 'Fuse_1206_3216Metric'), ('Fuse', 'Fuse_1812_4532Metric'), ('Fuse', 'Fuse_2920_7451Metric')

# passives: value -> LCSC (all JLC basic, checked against the basic list of 2026-10-31)
RES = {'10k': 'C25804', '1k': 'C21190', '100k': 'C25803', '4.7k': 'C23162', '330': 'C23138', '100': 'C22775',
       '2.2k': 'C4190', '75k': 'C23242', '22k': 'C31850', '1.5k': 'C22843'}
CAP = {'100nF': 'C14663', '1nF': 'C1588', '10uF 50V': 'C13585', '22uF 25V': 'C45783', '22nF': 'C21122'}

# v1.2: spring clamps Cixi Kefa KF250-3.5-nP-1 (3.5 mm pitch, 45 deg, push buttons, 0.2-0.75 mm2, 5 A),
# JLC extended parts, wave soldered by JLC (Economic PCBA). Footprint: pcb/lib/robo.pretty (fplib.py).
KF_LCSC = {2: 'C475154', 3: 'C475155', 4: 'C475156', 6: 'C475158'}


def kf(n):
    return ('robo', 'KF250-3.5-%dP_1x%02d_P3.50mm_45Degree' % (n, n))


P = {}


def add(ref, fp, val, x, y, rot, nets, lcsc=None, mpn=None, **kw):
    if lcsc is None:
        lcsc = RES.get(val) if fp == R0603 else CAP.get(val)
    P[ref] = dict(lib=fp[0], fp=fp[1], val=val, x=x, y=y, rot=rot, nets=nets, lcsc=lcsc, mpn=mpn, **kw)


def R(ref, val, x, y, rot, a, b):
    add(ref, R0603, val, x, y, rot, {'1': a, '2': b})


def C(ref, val, x, y, rot, a, b, fp=C0603):
    add(ref, fp, val, x, y, rot, {'1': a, '2': b})


def clamp(ref, n, val, x, y, rot, nets):
    add(ref, kf(n), val, x, y, rot, nets, lcsc=KF_LCSC[n], mpn='KF250-3.5-%dP-1' % n, tht=True)


# ================= ESP32 DevKitC V4 socket =================
# Three 1x19 sockets: J3 (top row) + J4 (outer bottom row, 25.4 mm) + J15 (inner bottom row, 22.86 mm).
# Both bottom rows are fitted and wired in parallel, so either DevKit width plugs in.
SOCKET = ('robo', 'PinSocket_1x19_P2.54mm_Vertical_Tight')   # courtyard = body, so J4 + J15 may touch
add('J3', SOCKET, 'DevKitC socket (5V..3V3)', DK_X0, DK_Y0, 90, j_top_nets(),
    lcsc='C2932678', mpn='KH-2.54FH-1X19P-H8.5', tht=True)
add('J4', SOCKET, 'DevKitC socket (CLK..GND) outer 25.4', DK_X0, DK_Y0 + ROW_WIDE, 90, j_bot_nets(),
    lcsc='C2932678', mpn='KH-2.54FH-1X19P-H8.5', tht=True)
add('J15', SOCKET, 'DevKitC socket (CLK..GND) inner 22.86', DK_X0, DK_Y0 + ROW_NARROW, 90, j_bot_nets(),
    lcsc='C2932678', mpn='KH-2.54FH-1X19P-H8.5', tht=True)

# ================= 12 V input + protection (top right) =================
# v1.3: rated 6 A continuous (12 V / 5 A PSU recommended; the old 3 A PSU still works).
# 4-pole clamp: 2 poles per polarity (KF250 = 5 A per pole: one pair for <= 5 A, both pairs above).
# F1 PTC 7 A hold / 14 A trip (2920, 24 V) -> Q1 AO4407C (SO-8, 11.5 mOhm) reverse-polarity P-FET.
# All 12 V branches behind F1 have their own limit: F4 valve 4 A, F7 aux 1.1 A (fan, button LED, beam, leak),
# DRV8874 current regulation (motor), LMR51430 current limit (5 V), F3/F5 0.2 A (beam / leak sensor feeds).
clamp('J2', 4, '12V IN', 92.8, 23.0, 90, {'1': 'GND', '2': 'GND', '3': '+12V_IN', '4': '+12V_IN'})
add('F1', F2920, 'PTC 7A 24V', 74.0, 14.25, 180, {'1': '+12V_IN', '2': '+12V_F'},
    lcsc='C495361', mpn='SMD2920P700SLR/24')
add('Q1', SOIC8, 'AO4407C', 70.6, 21.2, 90, {'1': '+12V', '2': '+12V', '3': '+12V', '4': 'Q1_G',
                                             '5': '+12V_F', '6': '+12V_F', '7': '+12V_F', '8': '+12V_F'},
    lcsc='C469397', mpn='AO4407C')
add('D1', ('Diode_SMD', 'D_SOD-123'), 'BZT52C12', 75.9, 23.9, 180, {'1': '+12V', '2': 'Q1_G'},
    lcsc='C43491', mpn='BZT52C12')                   # gate clamp: Vgs <= 12 V (AO4407C: +-25 V)
R('R1', '100k', 75.6, 20.5, 0, 'GND', 'Q1_G')
add('C1', ('Capacitor_SMD', 'CP_Elec_6.3x7.7'), '100uF 25V', 69.6, 30.4, 270, {'1': '+12V', '2': 'GND'},
    lcsc='C3338', mpn='RVT1E101M0607')
add('D2', ('Diode_SMD', 'D_SMA'), 'SMAJ15A', 63.6, 30.4, 270, {'1': '+12V', '2': 'GND'},
    lcsc='C148216', mpn='SMAJ15A')
C('C2', '10uF 50V', 74.4, 31.6, 90, '+12V', 'GND', fp=C1206)
add('F8', F1206, 'PTC 200mA 30V', 76.6, 27.8, 0, {'1': '+12V', '2': '+12V_BTN'},
    lcsc='C883118', mpn='BSMD1206-020-30V')           # v1.3: button ring LED (12 V, <= 50 mA)

# ================= 12 V -> 5.1 V buck (LMR51430, TI SLUSEF4 sec. 9.2) =================
UX, UY = 72.0, 43.0            # v1.3: 3 mm lower -> 12 V trunk corridor at y 37.8 under the antenna keep-out
add('U4', ('Package_TO_SOT_SMD', 'TSOT-23-6'), 'LMR51430XFDDCR', UX, UY, 0,
    {'1': 'GND', '2': 'SW', '3': '+12V', '4': 'FB', '5': 'EN', '6': 'CB'}, lcsc='C5219260', mpn='LMR51430XFDDCR')
add('L1', ('Inductor_SMD', 'L_Chilisin_BMRx00060630'), '6.8uH 6A', UX - 6.8, UY, 0, {'1': '+5V', '2': 'SW'},
    lcsc='C167221', mpn='FXL0630-6R8-M')
C('C20', '100nF', UX, UY - 4.0, 0, 'SW', 'CB')                      # bootstrap CB -> SW
C('C21', '100nF', UX, UY + 2.6, 0, '+12V', 'GND')                   # HF input cap
C('C22', '10uF 50V', UX, UY + 5.2, 0, '+12V', 'GND', fp=C1206)      # CIN
C('C23', '10uF 50V', UX, UY + 8.0, 0, '+12V', 'GND', fp=C1206)      # CIN
C('C24', '22uF 25V', UX - 13.4, UY - 1.2, 0, 'GND', '+5V', fp=C0805)  # COUT
C('C25', '22uF 25V', UX - 13.4, UY + 1.4, 0, 'GND', '+5V', fp=C0805)  # COUT
R('R26', '10k', UX + 3.6, UY + 0.95, 0, 'FB', 'GND')                # RFBB
R('R25', '75k', UX + 3.6, UY + 2.75, 0, 'FB', '+5V')                # RFBT -> 0.6 V * (1 + 75/10) = 5.1 V
R('R27', '100k', UX + 3.6, UY - 0.85, 0, 'EN', '+12V')              # EN tied to VIN
C('C26', '22uF 25V', UX - 13.4, UY + 4.0, 0, 'GND', '+5V', fp=C0805)  # COUT (3rd, DC-bias derating)
R('R4', '2.2k', UX - 13.4, UY + 6.8, 0, '+5V', 'LED_PWR')
add('LED1', ('LED_SMD', 'LED_0805_2012Metric'), 'green', UX - 13.4, UY + 9.0, 180, {'1': 'GND', '2': 'LED_PWR'},
    lcsc='C2297', mpn='KT-0805G')
add('D3', ('Diode_SMD', 'D_SOD-123'), 'B5819W', 7.5, 2.3, 0, {'1': '+5V_DEV', '2': '+5V'},     # next to the 5V pin
    lcsc='C8598', mpn='B5819W', noref=True)

# ================= v1.2: 12 V supply monitor -> GPIO36 (VP, ADC1_CH0) =================
# 100k / 22k divider: 12 V -> 2.16 V, 24 V -> 4.3 V, clamped by D7 (BAT54S) to 3V3 through the 10k.
R('R47', '100k', 10.5, 36.5, 0, '+12V', 'VMON')
R('R48', '22k', 13.5, 36.5, 270, 'VMON', 'GND')            # v1.3: vertical, VMON passes between
R('R49', '10k', 16.5, 36.5, 0, 'VMON', 'VP')
C('C32', '100nF', 10.5, 38.5, 0, 'VP', 'GND')
add('D7', SOT23, 'BAT54S', 14.0, 40.0, 0, {'1': 'GND', '2': '+3V3', '3': 'VP'}, lcsc='C408389', mpn='BAT54S', noref=True)

# ================= motor driver + current sense (left) =================
# v1.3: shunt 20 mOhm 2 W (INA219 range 16 A, 0.4 W at 4.5 A), Kelvin taps R28 / R29 pre-routed from the inner
# pad edges (the motor current never flows through them; finish.py checks it).
add('R6', ('Resistor_SMD', 'R_2512_6332Metric'), '20m 2W', 21.0, 41.0, 0, {'1': '+12V', '2': '+12V_MOT'},
    lcsc='C160589', mpn='RLP25FEER020')
add('U2', ('Package_TO_SOT_SMD', 'SOT-23-8'), 'INA219AIDCNR', 21.0, 48.4, 0,
    {'1': 'ISNS_P', '2': 'ISNS_N', '3': 'GND', '4': '+3V3', '5': 'IO22', '6': 'IO21', '7': 'GND', '8': 'GND'},
    lcsc='C87469', mpn='INA219AIDCNR')
add('R28', R0603, '0R', 18.6, 44.5, 270, {'1': '+12V', '2': 'ISNS_P'}, lcsc='C21189')      # Kelvin tap IN+
add('R29', R0603, '0R', 23.4, 44.5, 270, {'1': '+12V_MOT', '2': 'ISNS_N'}, lcsc='C21189')  # Kelvin tap IN-
C('C11', '100nF', 25.4, 48.4, 90, '+3V3', 'GND')
# v1.3: TI DRV8874 (6 A peak, 200 mOhm HS+LS, 37 V): PWM mode (PMODE high), fixed off-time current chopping with
# auto-retry OCP (IMODE = GND), I_TRIP = VREF / (450 uA/A x R_IPROPI) = 3.3 V / (450 uA/A x 1.5 k) = 4.9 A.
# nSLEEP + VREF + PMODE from +3V3 (no DevKit -> 3V3 floats -> internal pull-down -> sleep). nFAULT unused.
U1X, U1Y = 31.0, 71.0
add('U1', ('robo', 'TI_PWP0016J_HTSSOP-16_ThermalVias'), 'DRV8874PWPR', U1X, U1Y, 0,
    {'1': 'IO25', '2': 'IO26', '3': '+3V3', '5': '+3V3', '6': 'IPROPI', '7': 'GND', '8': 'MOT_A', '9': 'GND',
     '10': 'MOT_B', '11': '+12V_MOT', '12': 'VCP', '13': 'CPH', '14': 'CPL', '15': 'GND', '16': '+3V3', '17': 'GND'},
    lcsc='C1855818', mpn='DRV8874PWPR')
R('R5', '1.5k', U1X, U1Y + 5.0, 0, 'GND', 'IPROPI')                  # R_IPROPI -> I_TRIP 4.9 A
C('C9', '100nF', U1X + 6.6, U1Y + 0.2, 90, '+12V_MOT', 'GND')        # VM bypass, pad 1 on the VM bar
C('C33', '100nF', U1X + 6.15, U1Y - 2.4, 0, 'VCP', '+12V_MOT')       # VCP -> VM (charge pump storage)
C('C34', '22nF', U1X + 4.85, U1Y - 4.4, 0, 'CPL', 'CPH')             # charge pump flying cap (50 V X7R)
C('C10', '10uF 50V', U1X + 11.1, U1Y - 0.5, 90, '+12V_MOT', 'GND', fp=C1206)
add('C3', ('Capacitor_SMD', 'CP_Elec_6.3x7.7'), '100uF 25V', 40.0, 60.5, 90, {'1': '+12V_MOT', '2': 'GND'},
    lcsc='C3338', mpn='RVT1E101M0607')                # bulk at the driver (pad 1 = + at the bottom)
clamp('J5', 2, 'ACTUATOR', 11.0, 92.8, 0, {'1': 'MOT_A', '2': 'MOT_B'})

# ================= signal conditioning under the DevKit =================
R('R19', '10k', 15.5, 22.5, 90, 'REED_CL', '+3V3')
R('R22', '1k', 17.5, 22.5, 90, 'IO32', 'REED_CL')
C('C17', '100nF', 19.5, 22.5, 90, 'GND', 'IO32')
R('R20', '10k', 21.5, 22.5, 90, 'REED_OP', '+3V3')
R('R23', '1k', 23.5, 22.5, 90, 'IO33', 'REED_OP')
C('C18', '100nF', 25.5, 22.5, 90, 'GND', 'IO33')
R('R13', '10k', 27.5, 22.5, 90, 'FAN_TACH', '+3V3')
R('R14', '1k', 29.5, 22.5, 90, 'IO27', 'FAN_TACH')
C('C15', '1nF', 31.5, 22.5, 90, 'GND', 'IO27')
R('R21', '10k', 21.5, 10.0, 90, '+3V3', 'REED_DR')
R('R24', '1k', 23.5, 10.0, 90, 'REED_DR', 'IO18')
C('C19', '100nF', 25.5, 10.0, 90, 'IO18', 'GND')
R('R17', '10k', 15.5, 10.0, 90, '+3V3', 'BTN')
R('R18', '1k', 17.5, 10.0, 90, 'BTN', 'IO19')
C('C16', '100nF', 19.5, 10.0, 90, 'IO19', 'GND')
R('R7', '4.7k', 9.5, 10.0, 90, '+3V3', 'IO21')
R('R8', '4.7k', 11.5, 10.0, 90, '+3V3', 'IO22')
add('U3', ('Package_TO_SOT_SMD', 'SOT-23-5'), 'SN74AHCT1G125DBVR', 33.0, 11.0, 0,
    {'1': 'GND', '2': 'LED_IN', '3': 'GND', '4': 'LED_BUF', '5': '+5V'}, lcsc='C7484', mpn='SN74AHCT1G125DBVR')
R('R30', '1k', 29.5, 14.0, 90, 'IO16', 'LED_IN')                   # limits back-feed when only USB powers the ESP32
C('C12', '100nF', 36.5, 10.0, 90, '+5V', 'GND')
R('R10', '10k', 29.5, 10.5, 90, 'LED_IN', 'GND')
R('R9', '330', 36.5, 14.0, 90, 'LED_BUF', 'LED_DATA')

# ================= outputs =================
add('Q2', SOT23, '2N7002', 30.5, 85.0, 0, {'1': 'Q2_G', '2': 'GND', '3': 'FAN_PWM'}, lcsc='C8545', mpn='2N7002')
R('R11', '100', 26.5, 85.0, 90, 'Q2_G', 'IO17')
R('R12', '10k', 26.5, 81.0, 90, 'Q2_G', '+3V3')                    # fan off while the ESP32 boots
add('J6', ('Connector', 'FanPinHeader_1x04_P2.54mm_Vertical'), 'Fan 4-pin', 22.5, 95.0, 0,
    {'1': 'GND', '2': '+12V_A', '3': 'FAN_TACH', '4': 'FAN_PWM'}, lcsc='C240840', mpn='Molex 47053-1000', tht=True,
    npth=1.25)   # v1.3.1: latch peg hole 1.25 mm as on the Molex drawing SD-47053-001 (KiCad stock: 1.1, JLC: 1.3)
add('F2', F1206, 'PTC 2A 12V', 38.5, 78.0, 0, {'1': '+5V', '2': '+5V_LED'},
    lcsc='C883135', mpn='BSMD1206-200-12V')            # v1.3: 2 A hold (LED strip <= 1.5 A in a warm case)
add('C13', ('Capacitor_SMD', 'CP_Elec_8x10'), '470uF 16V', 48.0, 77.0, 90, {'1': '+5V_LED', '2': 'GND'},
    lcsc='C970706', mpn='RVT1C471M0810')
clamp('J7', 3, 'LED', 37.0, 92.8, 0, {'1': '+5V_LED', '2': 'LED_DATA', '3': 'GND'})
clamp('J10', 4, 'I2C', 55.0, 92.8, 0, {'1': '+3V3', '2': 'IO21', '3': 'IO22', '4': 'GND'})
add('J11', ('Connector_PinHeader_2.54mm', 'PinHeader_1x06_P2.54mm_Vertical'), 'EXP (optional)', 31.0, 35.0, 90,
    {'1': '+3V3', '2': 'GND', '3': '+5V', '4': 'IO14', '5': 'VN', '6': 'IO5'}, tht=True, dnp=True)
add('Q3', SOT23, 'AO3400A', 81.0, 32.2, 0, {'1': 'Q3_G', '2': 'GND', '3': 'RING_K'}, lcsc='C20917', mpn='AO3400A')
R('R16', '100k', 78.2, 32.6, 90, 'Q3_G', 'GND')
R('R15', '100', 80.5, 35.4, 0, 'IO23', 'Q3_G')
clamp('J8', 4, 'BUTTON', 92.8, 42.0, 90, {'1': 'BTN', '2': 'GND', '3': '+12V_BTN', '4': 'RING_K'})
clamp('J9', 6, 'REEDS', 92.8, 78.0, 90,
      {'1': 'REED_CL', '2': 'GND', '3': 'REED_OP', '4': 'GND', '5': 'REED_DR', '6': 'GND'})

# ================= v1.1: door light barrier (left edge) =================
# 6-pole clamp (pole 6 = spare GND), wires enter from the left: RX+ RX- SIG (receiver), TX+ TX- (emitter).
# Receiver: NPN output. SIG is pulled up to +12V (before F3), so a cut wire or a tripped F3 reads "blocked".
# Q5 turns the 12 V level into a clean 3.3 V signal (IO34 low = SIG high = no light / blocked).
# Q4 switches the emitter (low side): the ESP32 turns it off before every close and checks the receiver reacts.
BX, BY = 7.2, 47.0
clamp('J12', 6, 'BEAM', BX, BY, 270,
      {'1': 'BEAM_12V', '2': 'GND', '3': 'BEAM_SIG', '4': 'BEAM_12V', '5': 'BEAM_TX', '6': 'GND'})
add('F7', F1206, 'PTC 1.1A 30V', 18.0, 52.5, 270, {'1': '+12V', '2': '+12V_A'},
    lcsc='C21714343', mpn='BSMD1206-110-30V')         # v1.3: aux 12 V for fan, beam and leak sensor (1.1 A)
add('F3', F1206, 'PTC 200mA 30V', 21.0, 53.5, 90, {'1': '+12V_A', '2': 'BEAM_12V'},
    lcsc='C883118', mpn='BSMD1206-020-30V')
R('R31', '4.7k', 23.6, 53.5, 90, 'BEAM_SIG', '+12V_A')              # pull-up to 12 V: cut wire = blocked
R('R32', '10k', 25.2, 53.5, 90, 'BEAM_SIG', 'Q5_G')
R('R35', '10k', 24.6, 59.6, 90, 'Q5_G', 'GND')                      # 10k/10k: NPN residual <1.5 V stays off
C('C27', '1nF', 26.2, 59.6, 90, 'Q5_G', 'GND')
add('Q5', SOT23, '2N7002', 21.6, 59.6, 0, {'1': 'Q5_G', '2': 'GND', '3': 'IO34'}, lcsc='C8545', mpn='2N7002')
R('R36', '10k', 24.6, 64.5, 90, 'IO34', '+3V3')
add('Q4', SOT23, 'AO3400A', 21.6, 69.0, 0, {'1': 'Q4_G', '2': 'GND', '3': 'BEAM_TX'}, lcsc='C20917', mpn='AO3400A')
R('R33', '100', 26.2, 64.5, 90, 'IO13', 'Q4_G')
R('R34', '100k', 24.6, 69.0, 90, 'Q4_G', 'GND')                     # emitter off while the ESP32 boots

# ================= v1.2: water leak input (left edge, below BEAM) =================
# 4 poles, in this order: 3V3 (PTC F6, sensor load <= 50 mA), SIG, GND, 12V (PTC F5). 12V sits only next to GND
# (a stray strand / bridge can never put 12 V on 3V3 or SIG); +12V_LK has 0.3 mm clearance (net class Sig12). Works with
#  a) two bare electrodes between SIG and GND: IO4 drives SIG through R40 only while measuring (70 ms every
#     10 s, no DC across the electrodes -> no corrosion), IO35 (ADC1) reads the divider R40 / water:
#     dry 3.3 V, tap water (< 200 kOhm) below 2.2 V;
#  b) a sensor with a digital output: NPN / open collector (sinks SIG to GND when wet, powered from 12 V or 3V3;
#     add a 10k pull-up between the 3V3 and SIG poles, R40 alone is only 100k) or 3.3-5 V push-pull logic.
#     SIG reads 0 V or 3.3 V during the same measurement window. SIG: 0-5 V only.
# R41 + C31 filter, D4 clamps IO35 to 3V3 / GND (a 5 V logic high is fine).
LX, LY = 7.2, 70.5
clamp('J13', 4, 'LEAK', LX, LY, 270, {'1': '+3V3_LK', '2': 'LEAK_S', '3': 'GND', '4': '+12V_LK'})
add('F5', F1206, 'PTC 200mA 30V', 19.0, 83.0, 0, {'1': '+12V_A', '2': '+12V_LK'},
    lcsc='C883118', mpn='BSMD1206-020-30V', noref=True)
add('F6', F1206, 'PTC 200mA 30V', 19.0, 80.0, 0, {'1': '+3V3', '2': '+3V3_LK'},
    lcsc='C883118', mpn='BSMD1206-020-30V', noref=True)
R('R40', '100k', 19.5, 71.8, 0, 'IO4', 'LEAK_S')
C('C30', '1nF', 19.5, 74.3, 0, 'LEAK_S', 'GND')
R('R41', '10k', 22.5, 71.8, 0, 'LEAK_S', 'IO35')
C('C31', '100nF', 22.5, 74.3, 0, 'IO35', 'GND')
add('D4', SOT23, 'BAT54S', 19.5, 77.0, 0, {'1': 'GND', '2': '+3V3', '3': 'IO35'}, lcsc='C408389', mpn='BAT54S', noref=True)

# ================= 12 V valve output (right edge, between BUTTON and REEDS) =================
# v1.3: rated 3 A (12 V solenoid or motorised valve): IO2 -> R42 -> Q6 IRLTS6342 (TSOP-6, 22 mOhm at Vgs 2.5 V,
# 0.2 W at 3 A), SS34 flyback, F4 PTC 4 A hold / 8 A trip (3.2 A hold at 50 C). Poles from the top: 12V, VLV
# (switched return) - v1.3 swapped them so the two power paths do not cross. IO2 is a strapping pin: R43 low.
VX, VY = 92.8, 51.5            # pin 1 (VLV) at (90.0, 51.5), pin 2 (+12V) at (95.0, 48.0)
clamp('J14', 2, 'VALVE', VX, VY, 90, {'1': 'VALVE_K', '2': '+12V_VLV'})
add('F4', F1812, 'PTC 4A 16V', 80.0, 42.0, 270, {'1': '+12V', '2': '+12V_VLV'},
    lcsc='C47263807', mpn='BSMD1812-400-16V')
add('D5', ('Diode_SMD', 'D_SMA'), 'SS34', 80.0, 49.0, 270, {'1': '+12V_VLV', '2': 'VALVE_K'},
    lcsc='C8678', mpn='SS34')
add('Q6', SOT23_6, 'IRLTS6342', 80.4, 54.6, 0, {'1': 'VALVE_K', '2': 'VALVE_K', '3': 'Q6_G', '4': 'GND',
                                                '5': 'VALVE_K', '6': 'VALVE_K'}, lcsc='C152628', mpn='IRLTS6342TRPBF')
R('R42', '100', 75.9, 55.6, 0, 'IO2', 'Q6_G')
R('R43', '10k', 75.9, 53.9, 0, 'Q6_G', 'GND')

# ================= v1.2: buzzer (centre) =================
# MLT-8530 passive magnetic buzzer (3.6 V, 16 Ohm, 2.7 kHz): +5V -> R44 (10 Ohm) -> BZ1 -> Q7 (AO3400A) -> GND.
# ESPHome drives IO15 with a 2.7 kHz square wave (rtttl). IO15 is a strapping pin: R46 keeps it low at boot
# (only silences the boot ROM log). D6 is the flyback diode.
BZX, BZY = 56.0, 62.0
add('BZ1', ('robo', 'Buzzer_SMD_MLT-8530_8.5x8.5mm'), 'MLT-8530', BZX, BZY, 0, {'1': 'BZ_P', '2': 'BZ_K'},
    lcsc='C94599', mpn='MLT-8530')
add('R44', R1206, '10 1206', 47.8, 59.5, 0, {'1': '+5V', '2': 'BZ_P'}, lcsc='C17903')   # v1.3: 1206 (0.19 W)
add('D6', ('Diode_SMD', 'D_SOD-123'), 'B5819W', 56.0, 69.5, 0, {'1': 'BZ_P', '2': 'BZ_K'},
    lcsc='C8598', mpn='B5819W')
add('Q7', SOT23, 'AO3400A', 49.0, 65.0, 0, {'1': 'Q7_G', '2': 'GND', '3': 'BZ_K'}, lcsc='C20917', mpn='AO3400A', noref=True)
R('R45', '100', 45.3, 65.0, 0, 'IO15', 'Q7_G')
R('R46', '10k', 49.0, 62.0, 0, 'Q7_G', 'GND')

# ================= v1.1: SHT40 temperature / humidity (bottom-right, thermally isolated) =================
# Sits on an 8 x 8 mm island inside a C-shaped 1.5 mm milled slot; only 4 thin traces cross the neck.
# The case gives this corner its own vented chamber. No copper pour in the chamber.
SX, SY = 84.0, 92.0
add('U5', ('Sensor_Humidity', 'Sensirion_DFN-4_1.5x1.5mm_P0.8mm_SHT4x_NoCentralPad'), 'SHT41-AD1B', SX, SY, 0,
    {'1': 'IO21', '2': 'IO22', '3': '+3V3', '4': 'GND'}, lcsc='C7461861', mpn='SHT41-AD1B-R2')   # v1.3: SHT41 (stock)
C('C28', '100nF', SX + 2.3, SY, 90, '+3V3', 'GND')               # pad 1 (+3V3) below, pad 2 (GND) above
ISL = (80.0, 88.0, 88.0, 96.0)            # island x0, y0, x1, y1
SLOT_W, NECK = 1.5, (90.25, 93.75)        # slot width, neck y range (left side)
x0, y0, x1, y1 = ISL
o0, p0, o1, p1 = x0 - SLOT_W, y0 - SLOT_W, x1 + SLOT_W, y1 + SLOT_W
SLOTS = [[(o0, NECK[0]), (o0, p0), (o1, p0), (o1, p1), (o0, p1), (o0, NECK[1]), (x0, NECK[1]), (x0, y1),
          (x1, y1), (x1, y0), (x0, y0), (x0, NECK[0])]]
k = 0.4                                   # copper-to-edge clearance
KEEPOUTS = [(o0 - k, p0 - k, o1 + k, y0 + k), (o0 - k, y1 - k, o1 + k, p1 + k), (x1 - k, p0 - k, o1 + k, p1 + k),
            (o0 - k, p0 - k, x0 + k, NECK[0] + k), (o0 - k, NECK[1] - k, x0 + k, p1 + k)] + ANT_KEEPOUT
CHAMBER = (76.0, 84.0, 100.0, 100.0)     # case chamber around the sensor (partitions at x = 76 and y = 84)
NOPOUR = [(CHAMBER[0] + 0.6, CHAMBER[1] + 0.6, W - 0.3, H - 0.3)]

# v1.1.1: GND pins that only get 1 thermal spoke (tracks around them) -> solid pour connection instead.
# Q3 = 2 A ring-LED low-side switch (solid is better for current anyway), C16 = button debounce cap.
SOLID_PADS = ['Q3.2', 'C16.2', 'C11.2', 'J15.13', 'J4.19',   # v1.2: C11 (INA219); J15.13 / J4.19: boxed in on B.Cu
              'J2.1', 'J2.2', 'Q6.4', 'D2.2', 'C1.2',    # v1.3: 6 A return path, valve FET source, TVS / bulk GND
              'J11.2']                                   # v1.3: EXP header GND (not fitted), boxed in by the 12 V trunk

# ================= mounting holes + JLCPCB tooling holes =================
for i, (x, y) in enumerate([(96.5, 3.5), (3.5, 96.5), (96.5, 96.5), (3.5, 40.0)]):
    add('H%d' % (i + 1), ('MountingHole', 'MountingHole_3.2mm_M3'), 'M3', x, y, 0, {}, tht=True, nobom=True)
# v1.2: three 1.152 mm tooling holes for the assembly line (JLC: "tooling holes by customer"), far apart,
# outside the case posts (7 mm) and the copper-free sensor chamber for TH3.
for i, (x, y) in enumerate([(90.0, 3.5), (3.5, 90.0), (94.0, 90.0)]):
    add('TH%d' % (i + 1), ('robo', 'ToolingHole_JLCPCB_1.152mm'), 'tooling', x, y, 0, {}, tht=True, nobom=True)

# ================= pre-routed tracks (locked) =================
c, r = 0.775, 0.825          # 0603 cap / resistor pad offsets
TR = []          # (net, width, layer, [points])
# v1.2: +5V to D3 (5V OR-ing diode at the DevKit 5V pin) along the top edge, above the socket row; the router
# joins it at the corridor end beside the antenna keep-out (it does not always find this path on its own)
TR += [('+5V', 0.8, 'F', [(9.15, 2.3), (46.86, 2.3), (48.92, 4.36), (48.92, 6.46)])]
# v1.3: the router lost this link twice -> pre-route the whole corridor beside the antenna keep-out (x 49.55,
# 0.88 mm left for one signal beside the socket pins), 2 vias under the 12 V trunk, then to C24 (+5V side)
TR += [('+5V', 0.8, 'F', [(48.92, 6.46), (49.55, 7.09), (49.55, 35.6)]),
       ('+5V', 0.8, 'B', [(49.55, 35.6), (49.55, 39.7)]),
       ('+5V', 0.8, 'F', [(49.55, 39.7), (58.45, 39.7), (59.55, 40.8), (59.55, 41.8)])]
TR += [('SW', 0.6, 'F', [(UX - 1.14, UY), (UX - 2.0, UY)]),                                   # SW -> L1: 0.6 at the pin,
       ('SW', 1.2, 'F', [(UX - 2.45, UY), (UX - 3.8, UY)])]                                  # 1.2 mm onto the L1 pad
TR += [('SW', 0.4, 'F', [(UX - c, UY - 4.0), (UX - 3.4, UY - 4.0), (UX - 3.4, UY - 1.6)])]    # CBOOT -> SW
TR += [('CB', 0.3, 'F', [(UX + c, UY - 4.0), (UX + 1.14, UY - 0.95)])]                       # CBOOT -> CB
TR += [('GND', 0.3, 'F', [(UX - 1.14, UY - 0.95), (UX, UY - 0.5), (UX, UY + 1.7), (UX + c, UY + 2.6)])]
TR += [('+12V', 0.6, 'F', [(UX - 1.14, UY + 0.95), (UX - c, UY + 1.6), (UX - c, UY + 2.6)])]
TR += [('+12V', 0.8, 'F', [(UX - c, UY + 2.6), (UX - 1.48, UY + 5.2), (UX - 1.48, UY + 8.0)])]
TR += [('GND', 0.8, 'F', [(UX + c, UY + 2.6), (UX + 1.48, UY + 5.2), (UX + 1.48, UY + 8.0)])]
TR += [('+5V', 0.8, 'F', [(UX - 9.82, UY), (UX - 12.45, UY - 1.2)]),
       ('+5V', 0.8, 'F', [(UX - 9.82, UY), (UX - 12.45, UY + 1.4)])]
TR += [('FB', 0.25, 'F', [(UX + 1.14, UY + 0.95), (UX + 3.6 - r, UY + 0.95), (UX + 3.6 - r, UY + 2.75)])]
TR += [('EN', 0.25, 'F', [(UX + 1.14, UY), (UX + 2.0, UY), (UX + 3.6 - r, UY - 0.85)])]
VIAS = [('GND', UX + 2.9, UY + 5.2), ('GND', UX + 2.9, UY + 8.0), ('GND', UX + 5.4, UY + 0.95),
        ('GND', UX - 15.4, UY - 1.2), ('GND', UX - 15.4, UY + 0.9)]
TR += [('GND', 0.5, 'F', [(UX + 1.48, UY + 5.2), (UX + 2.9, UY + 5.2)]),
       ('GND', 0.5, 'F', [(UX + 1.48, UY + 8.0), (UX + 2.9, UY + 8.0)]),
       ('GND', 0.4, 'F', [(UX + 3.6 + r, UY + 0.95), (UX + 5.4, UY + 0.95)]),
       ('GND', 0.5, 'F', [(UX - 14.35, UY - 1.2), (UX - 15.4, UY - 1.2)]),
       ('GND', 0.5, 'F', [(UX - 14.35, UY + 1.4), (UX - 15.4, UY + 0.9)])]
TR += [('+5V', 0.8, 'F', [(UX - 12.45, UY + 1.4), (UX - 12.45, UY + 4.0)]),
       ('GND', 0.5, 'F', [(UX - 14.35, UY + 4.0), (UX - 15.4, UY + 4.9)])]   # v1.3: via below the back title
VIAS += [('GND', UX - 15.4, UY + 4.9)]
VIAS += [('+5V', 49.55, 35.6, 0.8, 0.4), ('+5V', 49.55, 39.7, 0.8, 0.4)]       # +5V corridor under the trunk
# v1.2: GND spokes by hand for the socket pins the router boxes in (J3.6 top row, J4.13 under the EXP header):
# a short locked track on each layer to a GND via counts as a thermal spoke for the KiCad DRC.
for (px, py), (vx, vy) in (((DK_X0 + 5 * 2.54, DK_Y0), (DK_X0 + 5 * 2.54, DK_Y0 + 2.6)),
                           ((DK_X0 + 12 * 2.54, DK_Y0 + ROW_WIDE), (DK_X0 + 12 * 2.54, DK_Y0 + ROW_WIDE + 2.1))):
    TR += [('GND', 0.4, 'F', [(px, py), (vx, vy)]), ('GND', 0.4, 'B', [(px, py), (vx, vy)])]
    VIAS += [('GND', vx, vy)]
# ---- v1.3 power pre-routes (locked; IPC-2221 external 1 oz, <= 20 C rise) ----
# 12 V IN: both +12V poles of J2 -> F1 (3.0 mm = 7 A), F1 -> Q1 drains (4.2 mm block), Q1 sources -> C1 + hub
# v1.3.1: KF250 zig-zag pins -- J2 pole 3 (rear row) at (90.0, 16.0), pole 4 (front row) at (95.0, 12.5)
TR += [('+12V_IN', 3.0, 'F', [(77.4, 14.25), (88.25, 14.25), (93.25, 14.25)]),   # junction = a segment end (a
       ('+12V_IN', 2.4, 'F', [(93.25, 14.25), (95.0, 12.5)]),                     # mid-track T counts as dangling)
       ('+12V_IN', 2.4, 'F', [(88.25, 14.25), (90.0, 16.0)]),
       ('+12V_F', 4.2, 'F', [(70.612, 14.25), (70.6, 18.0)])]
TR += [('+12V_F', 0.6, 'F', [(x, 18.0), (x, 18.725)]) for x in (68.695, 69.965, 71.235, 72.505)]   # each drain pin
TR += [('+12V', 1.2, 'F', [(68.695, 23.675), (71.235, 23.675)]),                     # source pins 1-3
       ('+12V', 2.4, 'F', [(69.965, 23.675), (69.965, 26.0), (69.6, 27.7)]),          # -> C1 + (bulk)
       ('Q1_G', 0.4, 'F', [(72.505, 23.675), (74.25, 23.9)])]
# shunt Kelvin taps from the inner pad edges (R28 / R29 = 0R net ties to the INA219 inputs)
TR += [('+12V', 0.3, 'F', [(18.038, 41.0), (18.45, 42.2), (18.6, 43.675)]),
       ('+12V_MOT', 0.3, 'F', [(23.962, 41.0), (23.55, 42.2), (23.4, 43.675)])]
# 12 V west trunk (motor 4.9 A + aux 1.1 A): hub -> left of the TVS -> under the antenna keep-out (y 37.8) -> R6 pad 1
# 2.0 mm = 4.9 A at ~17 C rise (IPC-2221 ext. 1 oz)
TR += [('+12V', 2.0, 'F', [(69.4, 25.2), (61.2, 25.2), (61.2, 37.8), (19.0, 37.8), (18.038, 38.76), (18.038, 41.0)]),
       ('+12V', 1.0, 'F', [(61.2, 28.4), (63.6, 28.4)]),                                    # TVS D2
       ('+12V', 0.3, 'F', [(9.675, 36.5), (9.675, 34.5), (18.8, 34.5), (18.8, 37.8)]),      # VMON divider R47
       ('+12V', 0.6, 'F', [(18.038, 39.6), (17.2, 40.4), (17.2, 50.4), (18.0, 51.1)]),     # aux PTC F7 (1.1 A)
       ('+12V', 0.8, 'F', [(61.2, 37.8), (65.2, 37.8), (65.2, 47.0), (69.4, 47.0), (UX - 1.475, UY + 5.2)]),
                                                             # buck VIN: between the L1 pads -> C22 (<= 1.5 A)
# 12 V east branch: hub (C1 +) -> between C1 and C2 -> C2 + -> F4 (valve, 4 A hold): 2.0 mm; F8 (button) 1.0 mm
       ('+12V', 2.0, 'F', [(69.6, 28.0), (72.1, 28.0), (72.1, 33.1), (74.4, 33.1), (80.0, 38.7), (80.0, 39.862)]),
       ('+12V', 1.0, 'F', [(72.1, 27.8), (75.2, 27.8)]),
       ('VMON', 0.25, 'F', [(11.325, 36.5), (15.675, 36.5)]),                              # R47 - R49 under R48
       ('VMON', 0.25, 'F', [(13.5, 35.675), (13.5, 36.5)]),
       ('+12V', 0.3, 'F', [(UX + 3.6 + 0.825, UY - 0.85), (78.6, 40.6), (80.0, 39.862)])]   # buck EN pull-up -> F4 pad
# motor supply: R6 -> C3 (bulk) -> VM bar (C9, C10, C33) -> DRV8874 VM pin; 2.0 mm (4.9 A at ~17 C rise), the VM pin
# neck (0.45 mm) is kept to 0.9 mm beyond the pad toe: VCP above, MOT_B below
TR += [('+12V_MOT', 2.0, 'F', [(23.962, 41.0), (28.5, 41.0), (33.4, 45.9), (33.4, 59.0), (37.6, 63.2), (39.8, 63.2),
                               (39.8, U1Y + 1.25)]),                                   # C3 (+ pad) -> VM bar
       ('+12V_MOT', 1.4, 'F', [(U1X + 5.6, U1Y + 1.25), (U1X + 11.1, U1Y + 1.25)]),     # VM bar: C9, C10
       ('+12V_MOT', 0.8, 'F', [(U1X + 4.75, U1Y + 1.35), (U1X + 5.6, U1Y + 1.35)]),
       ('+12V_MOT', 0.45, 'F', [(U1X + 2.86, U1Y + 0.975), (U1X + 4.3, U1Y + 0.975), (U1X + 4.75, U1Y + 1.35)]),  # neck
       ('+12V_MOT', 0.4, 'F', [(U1X + 6.925, U1Y - 2.4), (39.8, U1Y - 2.4)])]          # C33 VM side
# DRV8874 right column fan-out, top -> bottom: PMODE (router), GND (-> pad), CPL, CPH, VCP: nested, 0.4 mm pitch
TR += [('CPL', 0.25, 'F', [(U1X + 2.86, U1Y - 0.975), (U1X + 4.25, U1Y - 0.975), (U1X + 4.25, U1Y - 4.4),
                           (U1X + 4.075, U1Y - 4.4)]),
       ('CPH', 0.25, 'F', [(U1X + 2.86, U1Y - 0.325), (U1X + 4.65, U1Y - 0.325), (U1X + 4.65, U1Y - 3.5),
                           (U1X + 5.625, U1Y - 3.5), (U1X + 5.625, U1Y - 4.4)]),
       ('VCP', 0.25, 'F', [(U1X + 2.86, U1Y + 0.325), (U1X + 5.05, U1Y + 0.325), (U1X + 5.05, U1Y - 2.1),
                           (U1X + 5.375, U1Y - 2.4)])]
# DRV8874 outputs: 0.4 mm at the 0.65 mm pins, 1.2 mm as soon as the neighbour pads allow, the router continues (1.5 mm)
TR += [('MOT_B', 0.4, 'F', [(U1X + 2.86, U1Y + 1.625), (U1X + 3.8, U1Y + 1.625), (U1X + 4.4, U1Y + 2.225),
                            (U1X + 4.4, U1Y + 2.95)]),
       ('MOT_B', 1.2, 'F', [(U1X + 4.4, U1Y + 2.95), (U1X + 4.4, U1Y + 4.0)]),
       ('MOT_A', 0.4, 'F', [(U1X - 2.86, U1Y + 2.275), (U1X - 3.9, U1Y + 2.275), (U1X - 4.3, U1Y + 2.675)]),
       ('MOT_A', 1.2, 'F', [(U1X - 4.3, U1Y + 2.675), (U1X - 5.2, U1Y + 3.575)])]
# GND pins next to the PowerPAD: short stubs into the exposed pad (PGND 9, GND 15, IMODE 7)
TR += [('GND', 0.4, 'F', [(U1X + 2.86, U1Y + 2.275), (U1X + 1.4, U1Y + 2.275)]),
       ('GND', 0.3, 'F', [(U1X + 2.86, U1Y - 1.625), (U1X + 1.4, U1Y - 1.625)]),
       ('GND', 0.3, 'F', [(U1X - 2.86, U1Y + 1.625), (U1X - 1.4, U1Y + 1.625)])]
# valve FET: the four drain pins joined under the TSOP-6 body
TR += [('VALVE_K', 0.6, 'F', [(80.4 - 1.137, 54.6 - 0.95), (80.4 + 1.137, 54.6 - 0.95)]),
       ('VALVE_K', 0.6, 'F', [(80.4 - 1.137, 54.6 - 0.95), (80.4 - 1.137, 54.6)]),
       ('VALVE_K', 0.6, 'F', [(80.4 + 1.137, 54.6 - 0.95), (80.4 + 1.137, 54.6)])]
# SHT40 island: hand fan-out of the 0.8 mm-pitch DFN through the neck, ending left of the chamber wall (x = 76)
XE = 75.0
TR += [('GND', 0.3, 'F', [(XE, 90.9), (SX + 2.3, 90.9), (SX + 2.3, SY - 0.775)]),
       ('GND', 0.25, 'F', [(SX + 0.7, SY - 0.4), (SX + 2.3, SY - 0.4), (SX + 2.3, SY - 0.775)]),  # VSS -> C28 (leave the pad outwards:
       ('IO21', 0.25, 'F', [(XE, SY - 0.4), (SX - 0.7, SY - 0.4)]),
       ('IO22', 0.25, 'F', [(XE, SY + 0.4), (SX - 0.7, SY + 0.4)]),
       ('+3V3', 0.25, 'F', [(XE, 93.1), (SX + 2.3, 93.1), (SX + 2.3, SY + 0.775)]),
       ('+3V3', 0.25, 'F', [(SX + 0.7, SY + 0.4), (SX + 2.3, SY + 0.4), (SX + 2.3, SY + 0.775)])]  #  the footprint has a keepout body;
# v1.1.1: both end exactly in the C28 pad centres, so the autorouter sees them as connected)

# ================= silkscreen =================
# v1.2: JLCPCB standard silkscreen: text height >= 1.0 mm, stroke >= 0.153 mm, width:height ~ 1:6, 0.15 mm to pads.
# build.py derives the stroke from the size (max(0.17, size / 6)); checks.silk_text_conflicts() gates every text
# (pads, other silk, part courtyards, board edge) in build.py and finish.py.
TEXTS = []
TS = 1.0                                   # default text height (mm)
AUTHOR, HANDLE = 'David Gölzhäuser', 'idoodler'
REPO = 'github.com/idoodler/robo-garage'


def T(text, x, y, size=TS, rot=0, just='c', back=False, nudge=0.0, novia=False):
    """nudge > 0: build.py may move the text up to this far (mm) to the nearest spot without conflicts.
    novia: via keep-out under the text (title, author, repo), so router and stitching keep it intact. Other texts
    may get a via: JLCPCB then clips the silk at the hole (cosmetic only)."""
    TEXTS.append(dict(text=text, x=x, y=y, size=size, rot=rot, just=just, back=back, nudge=nudge, novia=novia))


PITCH = 3.5


def pin_labels_bottom(x0, labels, y=86.2):
    for k, s in enumerate(labels):
        T(s, x0 + PITCH * k, y)


def pin_labels_right(y0, labels, x=87.0):
    for k, s in enumerate(labels):
        T(s, x, y0 - PITCH * k, just='r')


def pin_labels_left(y0, labels, x=13.0):
    for k, s in enumerate(labels):
        T(s, x, y0 + PITCH * k, just='l')


# ---- front: clamp names + every pole
pin_labels_bottom(11.0, ['M+', 'M-'])
pin_labels_bottom(37.0, ['5V', 'DAT', 'GND'])
pin_labels_bottom(55.0, ['3V3', 'SDA', 'SCL', 'GND'])
pin_labels_right(23.0, ['GND', 'GND', '+12V', '+12V'])     # v1.3: 2 poles each
pin_labels_right(42.0, ['BTN', 'GND', '12V', 'LED-'])
pin_labels_right(VY, ['VLV', '12V'])
pin_labels_right(78.0, ['CLOSED', 'GND', 'OPEN', 'GND', 'DRAWER', 'GND'])
pin_labels_left(BY, ['RX+', 'RX-', 'SIG', 'TX+', 'TX-', 'GND'])
pin_labels_left(LY, ['3V3', 'SIG', 'GND', '12V'])
T('BEAM', 12.6, 42.9, just='l')
T('LEAK', 13.0, LY - 2.4, just='l')
T('DOOR ACTUATOR', 18.0, 88.6, just='l')
T('FAN PWM', 26.3, 91.0)
T('WS2812 LED', 40.5, 84.6)
T('I2C  ToF', 60.25, 84.6)
T('12 V IN', 87.0, 8.5, just='r')
T('BUTTON', 87.0, 28.3, just='r')
T('VALVE', 87.0, 44.9, just='r')
T('DOOR REEDS', 87.0, 57.2, just='r')
T('EXP: 3V3 GND 5V IO14 IO39 IO5', 37.35, 37.6)
T('BUZZER', BZX, BZY - 6.6)
T('<- USB-C   ESP32 DevKitC V4   antenna ->', 28.0, 2.4)
T('DevKit rows: 25.4 or 22.86', 3.0, 33.6, just='l')
# ---- front: circuit blocks
T('INPUT PROTECTION', 72.0, 2.4, nudge=3.0)
T('5V BUCK', 65.0, 46.6, nudge=3.0)
T('MOTOR DRV', 30.0, 67.2, nudge=3.0)
# ---- front: title, author, repo
T('ROBO-GARAGE v' + VERSION, 41.0, 43.0, 1.8, novia=True)
T('robot vacuum cabinet controller', 41.0, 45.6)
T(AUTHOR + ' · ' + HANDLE, 41.0, 48.0, novia=True)
T(REPO, 41.0, 50.2, novia=True)

# ---- back (mirrored, reads correctly from below): about, fuses, clamp limits, QR code to the repo
QR = dict(data='HTTPS://' + REPO.upper(), x=50.0, y=66.6, module=0.55, error='q', back=True, negative=True)
# negative = the light modules and the 4-module quiet zone are printed: dark modules on a white square, the normal
# polarity every phone camera reads (white modules on the green mask would need an 'inverted' scanner).
# upper case = QR alphanumeric mode: 39 characters fit version 3 (29 x 29) at ECC level Q (25 % may be damaged);
# GitHub resolves owner / repo names case-insensitively. Text block starts at y 46: GND vias of the buck sit above.
T('ROBO-GARAGE CONTROLLER v' + VERSION, 50.0, 46.0, 1.8, back=True, novia=True)
T('Robot vacuum cabinet  ·  ESPHome  ·  Home Assistant', 50.0, 48.9, 1.1, back=True)
T(AUTHOR + '  ·  ' + HANDLE, 50.0, 51.9, 1.6, back=True, novia=True)
T(REPO, 50.0, 54.7, 1.2, back=True, novia=True)
# v1.3 ratings: PTC hold currents at 25 C; the limits below keep >= 20 % margin for a warm case (~50 C)
for k, line in enumerate(['RESETTABLE FUSES (PTC)', 'F1  7 A    12 V IN', 'F2  2 A    LED 5 V', 'F3  0.2 A  BEAM',
                          'F4  4 A    VALVE', 'F5  0.2 A  LEAK 12V', 'F6  0.2 A  LEAK 3V3', 'F7  1.1 A  FAN 12V', 'F8  0.2 A  BUTTON',
                          'Reset: unplug 1 min']):
    T(line, 80.0, 58.2 + 1.75 * k, just='l', back=True)       # back: 'left' = as read from below (board x 80 -> 62)
for k, line in enumerate(['CLAMPS 0.2-0.75 mm², 5 A/pole', '12 V IN  max 6 A, PSU 12 V/5 A', 'ACTUATOR  3 A, limit 4.9 A',
                          'VALVE  12 V, max 3 A', 'LED  5 V, max 1.5 A', 'BEAM NPN Light-ON, LEAK 50 mA']):
    T(line, 38.0, 58.2 + 1.75 * k, just='l', back=True)       # ends above the U1 thermal pad (B.Cu, y 68.5)
T('PCB v' + VERSION + '  ·  made in code: KiCad + Freerouting  ·  2026', 50.0, 78.6, back=True)
