idoodler/robo-garage/(commit log)

2026-11-01 Robo-Garage: PCB v1.1.1, case v1.1, ESPHome config, simulator v5.1
    - pcb/gen: PCB generator (KiCad pcbnew), Freerouting result in pcb/robo-garage
    - pcb/out: JLCPCB gerbers/BOM/CPL, KiCad project, renders, order guide
    - case: OpenSCAD source, STL, pictures
    - esphome: ESPHome config
    - simulator: simulator page source, build scripts, built page
    - script paths are relative to the repo
    Claude-Session: https://claude.ai/code/session_01SF6zUtQEx4KoAD25JuKAp3
    [base.stl, lid_print.stl, pcb-v1.1.1.json, pcb_data.scad, robo-garage-case.scad, robo-garage.kicad_pcb, robo-garage_BOM_JLCPCB.csv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]
2026-11-01 Add GitHub Actions build + release
    - .github/workflows/build.yml: on every push build the PCB (DRC must pass),
    gerbers/BOM/CPL, case STL; keep both zips as artifacts; on tags v* publish
    a GitHub release with both zips
    - versions live in code: VERSION in pcb/gen/parts.py (silkscreen + zip name),
    version in case/robo-garage-case.scad
    - case/build.sh: pcb_data.scad -> STL -> zip
    - quote paths in the shell scripts; README: build + release steps
    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
    [robo-garage-case.scad]
2026-11-01 Workflow: also attach zips to releases made on github.com
    - trigger on release published (tag created in the web UI)
    - concurrency per ref, so a tag push and a release event never upload at the same time
    - README: web UI release steps
    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
2026-11-03 PCB v1.2, case v1.2, simulator v5.2: leak probe, valve output, buzzer, 12 V monitor, JLC-assembled clamps
    PCB v1.2 (pcb/gen/parts.py, fplib.py):
    - KF250-3.5 push-button spring clamps (LCSC C475154/5/6/8) replace WAGO 804: every BOM line
    has an LCSC number, JLCPCB assembles the whole board (SMD + THT), only the DevKitC is plugged in
    - LEAK clamp J13: pulsed probe drive IO4 -> 100k, ADC IO35, BAT54S clamp
    - VALVE clamp J14: AO3400A low side, SS34 flyback, PTC 1.5 A, IO2 with pull-down
    - buzzer MLT-8530 on 5 V, AO3400A, IO15 with pull-down, B5819W flyback
    - 12 V rail monitor 100k/22k on VP (IO36) with BAT54S clamp
    - third DevKit socket J15 (22.86 mm row pitch) next to J4 (25.4 mm)
    - JLCPCB re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
    [base.stl, lid_print.stl, pcb-v1.1.1.json, pcb-v1.2.json, pcb_data.scad, robo-garage-case.scad, robo-garage.kicad_pcb, robo-garage_BOM_JLCPCB.csv]
2026-11-03 Review fixes, USB-C socket opening in the case, case as 3D model in the simulator
    PCB v1.2 (after the independent datasheet review):
    - F4 valve PTC: ASMD1206-150 (6 V) -> BSMD1206-150-16V C883133 (16 V)
    - D7 BAT54S now gets a pin-1 silk dot (pin1_dots: fallback positions on the pad-1 side)
    - C1 (100 uF input cap) moved left of the 12 V input stage: frees the back wall for the USB-C socket; re-routed
    - fab.py: THT centroid without NPTH holes (J6), BOM 45 lines, order guide notes (F4, DevKit width, leak threshold)
    Case v1.2: USB-C panel-socket cut-out 11 x 7 + 2 M3 pilot holes (18 mm) with 4 mm bosses in the back wall,
    plug/socket stand-ins in the fit check (0 mm3), 'labels' flag, pcb_model p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
    [base.stl, lid_print.stl, pcb-v1.2.json, pcb_data.scad, robo-garage-case.scad, robo-garage.kicad_pcb, robo-garage_BOM_JLCPCB.csv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]
2026-11-03 Simulator: case model as base64 GLB in JSON (artifact host serves no .glb)
    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
2026-11-03 PCB v1.2: DevKit USB-C at the board edge (plug in through the case wall), LEAK clamp for electrodes or digital sensors
    - DevKitC rotated 180 deg and moved to x = 1.7: its USB-C face sits 1 mm outside the left board edge, the antenna
    points inboard over a copper / track keep-out (x 50-60); buck converter moved down out of the antenna area,
    D3 next to the 5V pin, C1 back to the input stage; sockets carry the reversed pin lists (top = 5V..3V3)
    - LEAK clamp J13 now 4 poles: 12V (PTC F5) + 3V3 (PTC F6) to power a sensor, SENSE, GND: bare electrodes
    or any sensor with a digital output (NPN / open collector / 3.3-5 V logic); ESPHome leak_inverted substitution
    - VALVE clamp J14 moved to the ri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
    [base.stl, lid_print.stl, pcb-v1.2.json, pcb_data.scad, robo-garage-case.scad, robo-garage.kicad_pcb, robo-garage_BOM_JLCPCB.csv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]
2026-11-03 PCB v1.2: descriptive silkscreen with author, repo and QR code; valve clamp between BUTTON and REEDS
    Silkscreen (JLCPCB standard: >= 1.0 mm text, 0.17 mm stroke, 0.15 mm to pads):
    - front: every clamp named, every pole labelled (REEDS: CLOSED / OPEN / DRAWER), circuit blocks
    (INPUT PROTECTION, 5V BUCK, MOTOR DRV), title, "David Gölzhäuser · idoodler", github.com/idoodler/robo-garage
    - back (mirrored): title, author, repo, QR code to the repo (version 3, ECC Q, decoded from the render),
    fuse table, clamp limits
    - build.py: references placed where they fit (never on a label's text line), nudging for block labels,
    via keep-outs under title / author / repo / QR (exported to Freerouting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
    [base.stl, lid_print.stl, pcb-v1.2.json, pcb_data.scad, robo-garage-case.scad, robo-garage.kicad_pcb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]
2026-11-03 Final validation fixes: LEAK pole order + 12 V clearance, negative QR, case USB-C margins
    Found by the pre-release review, fixed before ordering:
    - LEAK clamp J13 poles now 3V3 / SIG / GND / 12V: 12 V only next to GND, so a stray strand or a solder
    bridge can never put 12 V on the 3V3 rail or SIG; +12V_LK in a new net class Sig12 (0.3 mm clearance)
    - documented limits: LEAK 3V3 pole <= 50 mA (shares the DevKit regulator), SIG 0-5 V, NPN sensors need
    10k between the 3V3 and SIG poles; LED / VALVE 1.2 A continuous (1.5 A PTCs derate when warm)
    - QR code printed negative (light modules + quiet zone): normal polarity, readable without "inverted" scanners
    - +5V to D3 pre-routed along the top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
    [base.stl, lid_print.stl, pcb-v1.2.json, robo-garage-case.scad, robo-garage.kicad_pcb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]
2026-11-03 PCB v1.3: power headroom, IPC-2221 copper check, JLC stock + datasheet validation
    - 12 V input 6 A: 4-pole clamp, PTC 7 A (2920), AO4407C reverse-polarity FET, TVS SMAJ15A
    - Actuator: DRV8874 (4.9 A current limit, 3 A moves), 20 mOhm / 2 W shunt with Kelvin taps (INA219 range 8 A)
    - Valve: IRLTS6342 + PTC 4 A (3 A continuous); aux 12 V behind own PTCs (F7 1.1 A, F8 0.2 A); LED PTC 2 A; SHT41
    - Copper: 12 V west trunk, east branch (valve) and motor supply pre-routed at 2.0 mm, buck input under L1,
    +5V corridor beside the antenna keep-out, DRV8874 VM / OUT fan-outs widened; finish.py widens the motor
    tracks to 1.8 mm wherever the clearances allow (post.widen)
    - Checks: DRC 0 errors / 0 war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
    [base.stl, lid_print.stl, pcb-v1.2.json, pcb-v1.3.json, pcb_data.scad, robo-garage-case.scad, robo-garage.kicad_pcb, robo-garage_BOM_JLCPCB.csv]
2026-11-03 PCB v1.3.1: KF250 clamp pins in two rows, CPL rotations from JLC's own footprints
    - KF250-3.5 clamps: the real part (datasheet + JLC footprint C475154..8) has its poles in two
    rows 5.0 mm apart (odd poles 2.2 mm, even 7.2 mm from the rear face); v1.3 had one row.
    Footprint fixed (body unchanged), J2 +12V_IN pre-route adapted, board re-routed: DRC clean.
    - fab.py computes each CPL rotation from JLC's library footprint (pcb/gen/jlc_footprints.json,
    EasyEDA data used by JLC) by pad position + pin function, and stops if a part fits no
    rotation. Replaces the package rules, which were tuned on hand-corrected preview pictures.
    Corrected: U2, U3 (180), Q6 (270), C13 (90), BZ1 (270), J6 (18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
    [base.stl, lid_print.stl, pcb-v1.3.1.json, pcb-v1.3.json, pcb_data.scad, robo-garage-case.scad, robo-garage.kicad_pcb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]
2026-11-03 PCB v1.3.1: fan header peg hole 1.25 mm (Molex SD-47053-001)
    KiCad's stock FanPinHeader footprint drills the latch peg hole at 1.1 mm; Molex recommends
    1.25 +-0.05 (JLC's library: 1.3). Override via parts.py npth=; clearance to the nearest
    copper 0.41 mm, DRC clean, routing unchanged.
    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
    [pcb-v1.3.1.json, robo-garage.kicad_pcb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]
2026-11-06 Change device_class from garage to damper
2026-11-07 Doors v2.0: printed parts for all 4 door types
    Replaces lift/ (parallel lift v1.0) with doors/:
    - Parallel lift v2.0: new arm geometry (R 77 mm, 100 deg swing). Parks 23 mm in
    front of the drawer front (v1.0: ~97 mm), max 40 mm while moving, 3.5 mm gap
    to it. Needs an 18 mm 45 deg chamfer on the door's top back edge. Actuator
    max 14 N.
    - Up & over v1.0: print-in-place modules (arm + lever, door bracket with peg),
    printed tracks, top mount, drill template. Open, the door lies flat 137 mm
    above the tray, 13 mm out (35 mm while moving). Door 202 mm tall.
    - Lift door: 4 printed channels, saddle, foot, clamp.
    - Flap out: printed lever + actuator top mount.
    - Checks over the whole travel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
    [coupon.stl, flap.scad, flap_lever.stl, flap_mount.stl, lift-door.scad, lift_channel.stl, lift_clamp.stl, lift_foot.stl]
2026-11-07 Simulator v5.4: door open slider, printed door parts in 3D and side view
    - "Door open" slider (3D card + side view, kept in sync) for all 4 door types.
    Auto gives the door back to the cleaning simulation. Live readout: mm out in
    front of the drawer front, free height under the door.
    - Door kinematics generated from the SCAD echo values (build_doors.py, exec'd
    by build_page.py). Printed parts as a GLB (files/doors-model-v2.0.json, node
    origin = pivot) and side outlines (door2d.json) from build_door_files.py,
    which build_files.py runs.
    - "Door" camera close-up; the robot turns see-through while the door is held.
    - New "Door parts" card: picture, PETG weight, out open/moving, one zip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
2026-11-07 Doors v2.1: stronger, lighter print-in-place hinges
    Parallel lift and up & over modules, still one print without supports.
    Estimated printed filament per module pair: parallel lift 326 -> 217 g,
    up & over 270 -> 166 g. Not yet test-printed.
    - Hourglass pin in a lipped ring, thickest at the root; flank gap 0.45 mm
    - Skeleton wall plates, rib routes and widths from plane-stress FE
    - Bracket underside grows at 45 deg instead of a 19 mm bridge
    - Tapered front arms, slimmer rear arms, up & over peg 10 mm with longer slot
    - 2.25 deg flange wedge against door lean from joint play
    - Rod socket 15 mm deep and tighter, 3 door screws 3.5 x 16 per bracket
    - Coupon gains the big P1 joint
    - Checks: force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
    [coupon.stl, parallel-lift.scad, parallel_left.stl, parallel_right.stl, parallel_template.stl, up-over.scad, upover_left.stl, upover_right.stl]
2026-11-07 Doors guide: glue the door flanges, add a physical test before fitting
    Door screws alone are estimated at safety factor 0.5-0.75 for a 150 N corner
    pull. Bonding the flange face takes that load off them; the adhesive strength
    is not tested. The design has not been printed, so the guide now gives
    pass/fail tests for the joints and pins.
2026-11-08 Doors v2.2: lighter, stronger print-in-place hinges, strength check
    Parallel lift v2.2 and up & over v1.2, still one print each without
    supports. Nothing test-printed: every claim below is calculated.
    Filament (PrusaSlicer 2.8.1, guide settings), both module pairs:
    404 -> 356 g (-12 %), print time 36 h 05 -> 32 h 21.
    Most loaded spot at a 100 N actuator stall: 1.35 -> 0.87 of its
    allowable (3D FE as printed). At a 50 N stall: safety factor 2.4
    (parallel lift) and 2.3 (up & over), v2.1 had 1.5.
    - 4 mm hole through every 11 mm pin: walls fill the pin in any slicer
    (Orca/Bambu and Prusa printer profiles printed v2.1's pin cores as
    20 % infill)
    - Arm rings run into the arm as a 14 mm taper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
    [coupon.stl, parallel-lift.scad, parallel_left.stl, parallel_right.stl, parallel_template.stl, up-over.scad, upover_left.stl, upover_right.stl]
2026-11-08 Parallel lift: drill template on A4 paper instead of a print
    parallel_template.pdf, made by paper_template.py from the screw and
    pivot positions in parallel-lift.scad, so it always matches the modules.
    A4 at 1:1, page 1 right cheek, page 2 left cheek, both seen from the
    robot bay. Cut lines for the front leg and the tray, 3 mm pilot
    crosses with their distances, faint plate outline, 100 mm check bars.
    - build.sh writes the PDF (needs matplotlib) and no longer exports
    parallel_template.stl; the zip includes it
    - Guide step 1 and file list, root README dependencies
    - Simulator: parallel download carries the PDF, the print list and
    PETG estimate drop the template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
    [parallel_template.stl]
2026-11-08 Light barrier: retroreflective sensor + reflector (no PCB change)
    The BEAM clamp now takes a retroreflective NPN sensor (E3Z-R61 type) with
    its reflector instead of a through-beam pair:
    - Wiring: brown -> RX+, black -> SIG, blue -> TX- (RX-, TX+, GND free).
    Q4 then switches the whole sensor off for the self-test and the input
    must read "blocked". Mode switch on L (Light-ON): Dark-ON fails the test.
    - ESPHome: comments for the new wiring; the wait for the beam after the
    self-test 1 -> 2 s (power-up of the sensor; it returns as soon as the
    reflector is seen). Checked with ESPHome 2026.10.1.
    - Order guide (pcb/out/README.md) + its config copy: part, wiring, pin 13.
    PCB files (gerbers,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
    [build_js.py, build_page.py, robo-garage-pcb.yaml]
2026-11-09 Line LED: SK6812 RGBW 144 LEDs/m, 72 LEDs, power capped (no PCB change)
    - ESPHome: Line = SK6812, channel_colors GRBW, num_leds 72 (one 50 cm
    segment), color_correct 25 % per channel: at most ~1.44 A at full RGBW
    (0.4 W per LED assumed) on the 1.5 A LED output (F2). The leak alarm sets
    white 0 % so the red strobe stays red. Dot / Ring / Underglow stay WS2812B
    (comment). Checked with ESPHome 2026.10.1.
    - Order guide + config copy: LED rating and clamp text. PCB files unchanged.
    - Simulator v5.6: own BOM row for the Line strip (Xnbada SK6812 RGBW,
    RGBNW, 144/m, IP30), 72 LEDs in 3D, chase/spinner keep their speed and
    tail in cm and move smoothly; the YAML on the page follows the LE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
    [build_js.py, build_page.py, robo-garage-pcb.yaml]
2026-11-13 ESPHome: beam and actuator settings in HA, motor fault check, tunable door
    - Beam type select (Light-ON / Dark-ON / None) replaces the beam_inverted
    substitution; changing it re-runs the self-test. Keep Light-ON with the
    retroreflective sensor (self-test switches it off via TX-)
    - Actuator type select (no / built-in limit switches); end of travel from the
    motor current dropping below the threshold for 0.3 s
    - Door motor fault: a move that draws no current within 1.5 s stops the door
    - HA numbers: open / close time, motor current threshold, stall current
    (replace the stall_current substitution)
    - HA cover without position percentage (internal endstop drive + template cover)
    - Rear fan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
    [robo-garage-pcb.yaml]
2026-11-13 Home Assistant blueprint: door follows the robot vacuum, clean button, ring, messages
2026-11-13 Blueprint: iOS Live Activities, rear fan drying run after parking
2026-11-13 Blueprint: take over the Dreame Live Activities (job progress + problems), motor fault = door not open
2026-11-13 Blueprint: no door opening for the mop wash after the job, lights follow problems and job progress
    The Dreame reports "cleaning" while it washes its mop in the dock after a job
    (started = false, docked = true): that opened the door. Robot home now means
    state docked or the docked attribute; leaving needs started != false.
    Status LED: problem strobe, door chase, progress bar, spinner, pulse, done.
    Ring: on parked, pulse during a job in the dock, blink on a problem.
    ESPHome: "Status LED progress" number + "Progress" effect, ring Pulse / Blink.
    [robo-garage-pcb.yaml]
